rtek1000/Datalogger_2039/Hardware/readme.md

Note:
- For new projects with USB Host and certain models of STM32 it may be recommended to use an external PHY:

https://community.st.com/t5/stm32-mcu-products/is-it-possible-to-use-usb-hub-with-stm32f4-using-external-phy/m-p/569817/highlight/true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

https://community.st.com/t5/embedded-software-mcus/stm32f429-discovery-as-usb-host-problems-enumerating-low-speed/m-p/306947/highlight/true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

---------

Note:
- Editing software: KiCad E.D.A. Version: 5.1.6 [https://www.kicad.org/]

Note: Apparently there were no problems when opening the project with Kicad v6, only the first time it failed, in the following it opened the schema correctly.

Hardware Licence:
Released under CERN OHL 1.2: https://ohwr.org/cernohl
