rtek1000/Datalogger_2039/Software/README.md

Current firmware (*.hex file): [here](https://github.com/rtek1000/Datalogger_2039/tree/main/Software/Datalogger_2039%20-%20STM32/BIN/Evaluation%20version)

Current file converter: [here](https://github.com/rtek1000/Datalogger_2039/tree/main/Software/Datalogger_2039%20-%20SharpDevelop/Bin)

Notes:
- If you are using a browser on your smartphone, use the landscape screen to read more characters in the file names.
- - (These files have already been cited elsewhere, and changing the name of the folders causes corruption of the references)

- USB_HOST_HID_MSC_LCD_FLASH_RTC_ACC_TEMP3 (STM32F407VGT6 firmware):
-- Editing software: STM32CubeIDE version: 1.6.1 [https://www.st.com/en/development-tools/stm32cubeide.html]
-- Editing software: STM32CubeIDE version: 1.7.0 [https://www.st.com/en/development-tools/stm32cubeide.html]
-- Editing software: STM32CubeIDE version: 1.8.0 [https://www.st.com/en/development-tools/stm32cubeide.html]
-- Initial code development language: Brazilian Portuguese (ABNT2) [http://kbdlayout.info/KBDBR/]

- Modification:
-- 2022/02/12, LCD Backlight flashing, PWM frequency changed from ~300Hz to ~82kHz, (htim8.Init.Prescaler: from 539 to 1)

- Datalogger_2039 - STM32 - FreeRTOS - CMSIS_V1
-- Editing software: STM32CubeIDE version: 1.9.0 [https://www.st.com/en/development-tools/stm32cubeide.html]

- Datalogger_2039_File_Converter (Encoded file to decoded file):
-- From *.dat file to *.xlsx file extension
-- Editing software: B4J version: 9.30 [https://www.b4x.com/b4j.html]
-- Binary file generated by B4J (Used in the installation file: BIN folder)
-- Initial code development language: English
-- Using WPS Office to verify the exported file
-- Installation file (BIN folder) generated by Inno Setup program [https://jrsoftware.org/isinfo.php]

- Datalogger_2039_File_Converter (Encoded file to decoded file):
-- Smaller executable size, better to run on Windows XP (OffLine computer)
-- From *.dat file to *.csv file extension
-- Editing software: SharpDevelop version: 4.4.1 [https://sourceforge.net/projects/sharpdevelop/]
-- Binary file generated by SharpDevelop (Used in the installation file: BIN folder)
-- Initial code development language: English
-- Using WPS Office to verify the exported file
-- Installation file (BIN folder) generated by Inno Setup program [https://jrsoftware.org/isinfo.php]

Software License:
This library is free software; you can redistribute it and/or modify it under the terms of the GNU Lesser General Public License as published by the Free Software Foundation; either version 2.1 of the License, or (at your option) any later version.

This library is distributed in the hope that it will be useful, but WITHOUT ANY WARRANTY; without even the implied warranty of MERCHANTABILITY or FITNESS FOR A PARTICULAR PURPOSE. See the GNU Lesser General Public License for more details.

You should have received a copy of the GNU Lesser General Public License along with this library; if not, write to the Free Software Foundation, Inc., 51 Franklin St, Fifth Floor, Boston, MA 02110-1301 USA
