rtek1000/Datalogger_2039/Hardware/Hardware_2.0/Readme.md

To do:
- Check the project
- Update LCSC codes from parts list (BOM)
- Panelize the board for production (add tabs)

Note:
- The software needs to be updated to operate the battery gauge.

##### Board
- Size: 80x150mm (GERBER: 94x150mm)

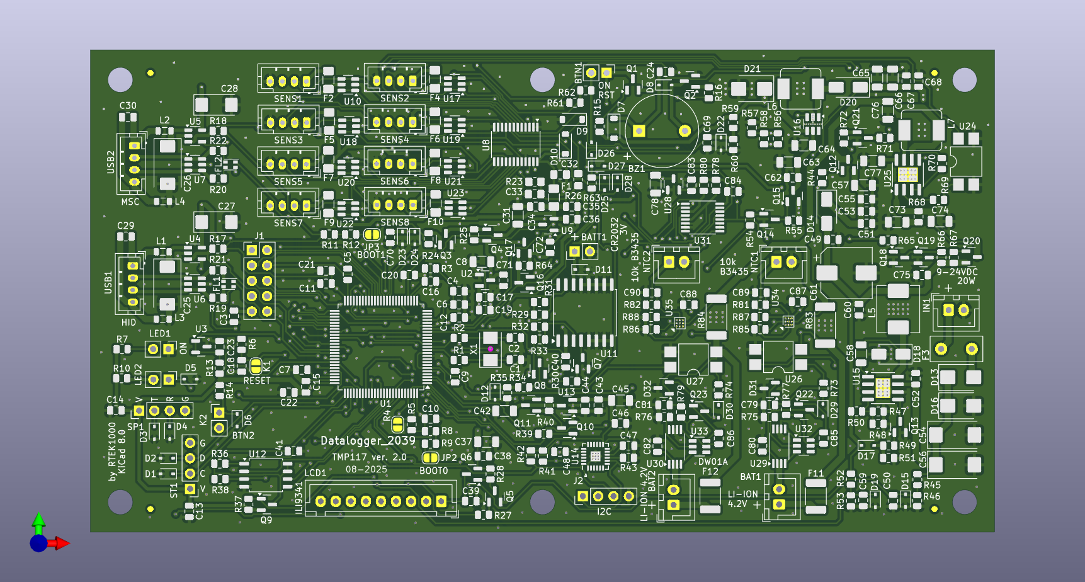
[picture p5: Hardware/Hardware_2.0/Datalogger_2039_Single_Board_T.png]


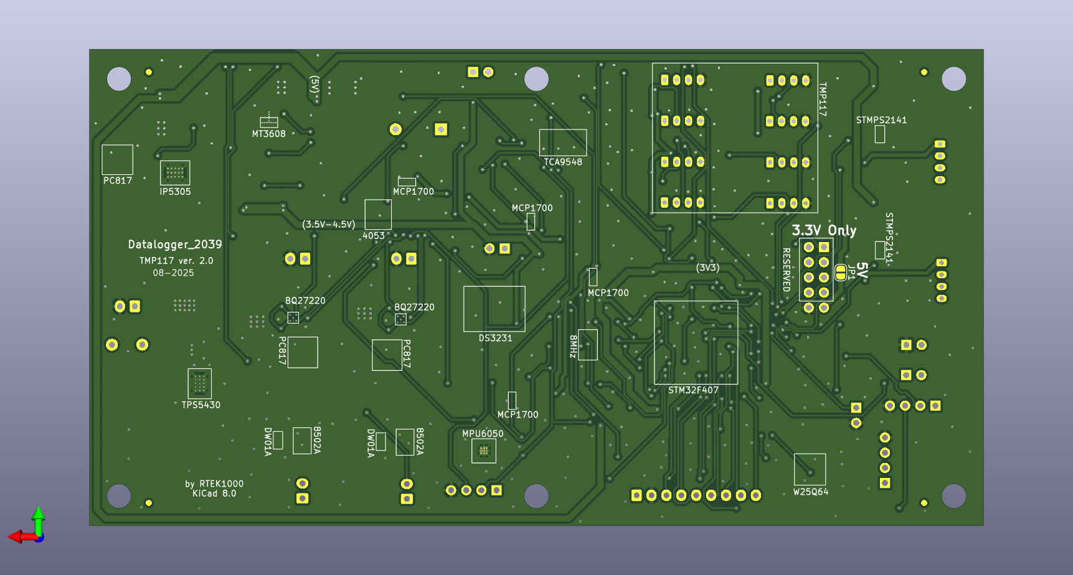
[picture p6: Hardware/Hardware_2.0/Datalogger_2039_Single_Board_B.png]


##### JLCPCB:
Notes:

- JLCPCB increased the price of the board by 9x
- - JLCPCB responded about the price being increased due to the hole size being too small

> This PCB has a minimum hole size of 0.15 mm (outer diameter 0.25/0.3 mm). High-precision PCBs with 0.15 mm (0.25/0.3 mm) vias are more difficult to manufacture. To ensure board quality, the options “4-Wire Kelvin Test” and “FR4 Tg155” are automatically applied, which led to the price increase.

- Small holes (0.15mm) have been enlarged to 0.25mm

##### Schematic
- Battery Gauge

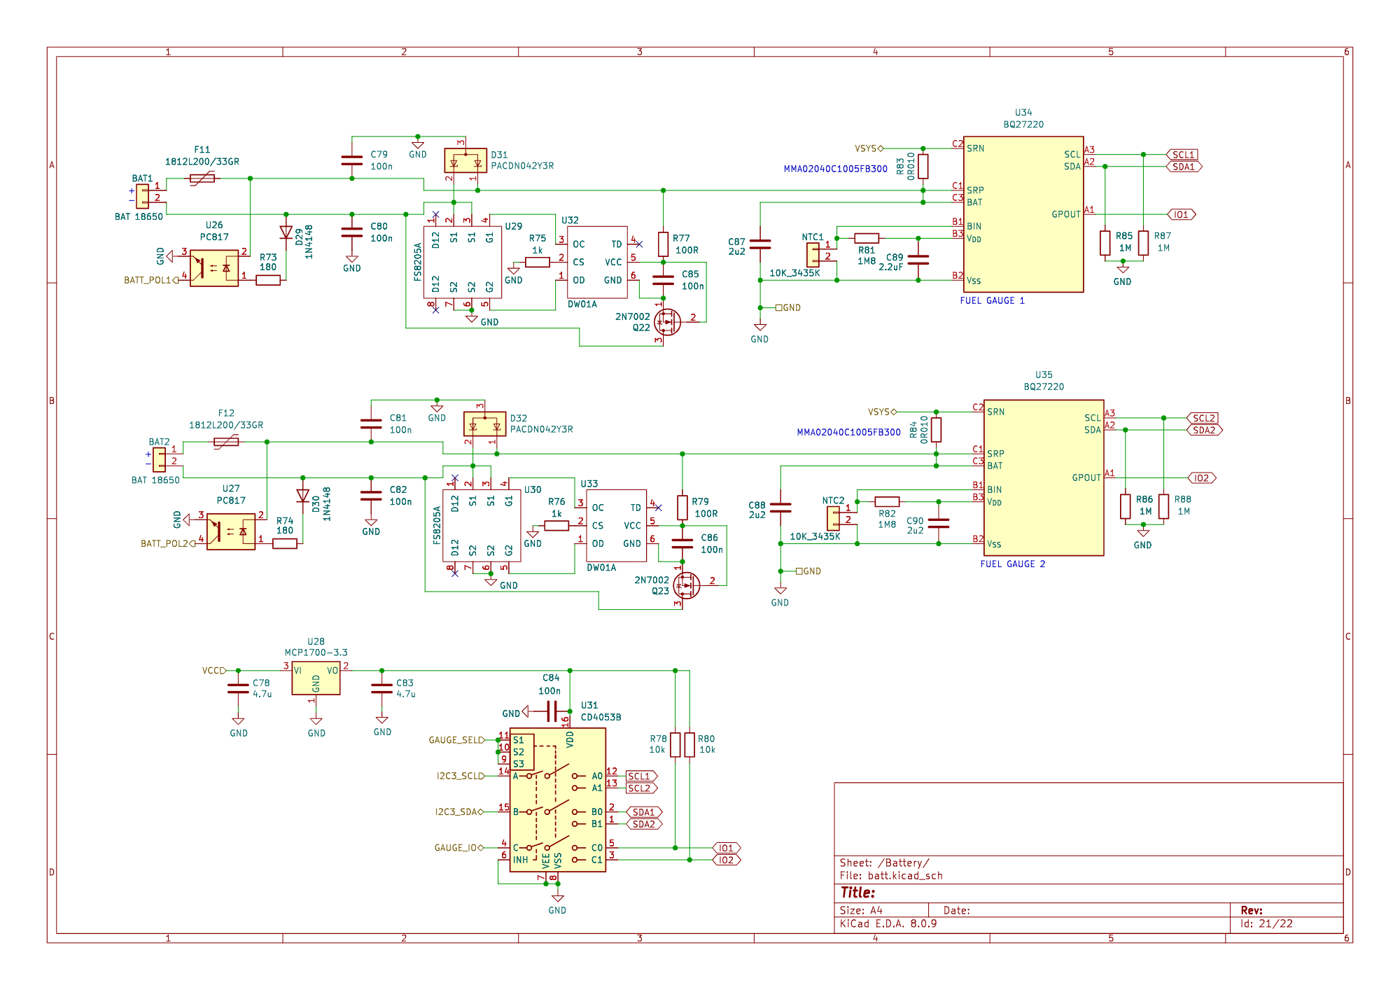
[picture p7: Hardware/Hardware_2.0/Battery_Gauge_Schematic.png]
