rtek1000/Datalogger_2039/Software/Datalogger_2039 - SharpDevelop/README.md

Current version is 0.0.7 (see [Bin](https://github.com/rtek1000/Datalogger_2039/blob/main/Software/Datalogger_2039%20-%20SharpDevelop/Bin/) folder)

If you are using a browser on your smartphone, use the landscape screen to read more characters in the file names.
- (These files have already been cited elsewhere, and changing the name of the folders causes corruption of the references)
