rtek1000/Datalogger_2039/Hardware/Datalogger2039_MCU_Pinout.xlsx

STM32F407VGT6
PA0 | ADC_VBAT | PB0 | HC595_OE (H) | PC0 | CHARGER_STATE (I, PU) | PD0 | FLASH_WP (H) | PE0 | LED2 | PH0 | OSC
PA1 | ETH_REF_CLK | PB1 | HC595_LAT | PC1 | ETH_MDC | PD1 | FLASH_PWR | PE1 | RTC_PWR | PH1 | OSC
PA2 | ETH_MDIO | PB2 | BOOT1 | PC2 |  | PD2 | UC_PWR (H) | PE2 | BUZZER
PA3 | ADC_CHARGER | PB3 | SPI1_SCK | PC3 | RTC_RESET | PD3 |  | PE3 | DC_DC_ON
PA4 | ADC_DC_DC_5V | PB4 | SPI1_MISO | PC4 | ETH_RXD0 | PD4 | LCD_PWR | PE4 | I2C3_PWR
PA5 |  | PB5 | SPI1_MOSI | PC5 | ETH_RXD1 | PD5 | LCD_RST | PE5
PA6 | ADC_VREF | PB6 | I2C1_SCL | PC6 | LCD_BACK_PWM | PD6 | LCD_DC | PE6 | ETH_PWR | (PU) | PULL-UP
PA7 | ETH_CRS_DV | PB7 | I2C1_SDA | PC7 | USB_FS_OC (I) | PD7 | LCD_CS (H) | PE7 | SENSOR_PWR | (H) | HIGH
PA8 | I2C3_SCL | PB8 | HC595_CLK | PC8 | USB_FS_PWR (H) | PD8 | USB_HS_PWR (H) | PE8 | SENSOR1 | (I) | IRQ,15,15
PA9 | USART1_TX | PB9 |  | PC9 | I2C3_SDA | PD9 | USB_HS_OC (I) | PE9 | SENSOR2 | SWD
PA10 | USART1_RX | PB10 | HC595_DAT | PC10 | SPI3_SCK | PD10 |  | PE10 | SENSOR3 | IN
PA11 | USB_FS_DM | PB11 | ETH_TX_EN | PC11 | SPI3_MISO | PD11 | BUTTON1 (I) | PE11 | SENSOR4 | ADC
PA12 | USB_FS_DP | PB12 | ETH_TXD0 | PC12 | SPI3_MOSI | PD12 | RTC_INT_STATE | PE12 | SENSOR5 | OUT
PA13 | (RST STATE) SWDIO | PB13 | ETH_TXD1 | PC13 |  | PD13 | AC_DC_STATE | PE13 | SENSOR6 | AUTO
PA14 | (RST STATE) SWCLK | PB14 | USB_HS_DM | PC14 |  | PD14 |  | PE14 | SENSOR7
PA15 | FLASH_CS (HIGH) | PB15 | USB_HS_DP | PC15 |  | PD15 | BUTTON2 | PE15 | SENSOR8
ADC |  |  |  |  | USB_OTG_FS |  |  |  |  | LCD
NVIC |  |  |  |  | MODE |  | HOST Only |  |  | 0 | VCC
ADC1/2/3 GLOB INT |  | ENABLED |  |  |  |  |  |  |  | 1 | GND
PRIORITY |  | 2 |  |  |  |  |  |  |  | 2
ADC1,2,3: PA0, PA3, PA4, PA6 |  |  |  |  | USB_OTG_HS |  |  |  |  | 3
 |  |  |  |  | MODE |  | HOST Only |  |  | 4
 |  |  |  |  | Internal FS PHY |  |  |  |  | 5
TMR7 |  |  |  |  |  |  |  |  |  | 6
MODE |  | ACTIVATED |  |  |  |  |  |  |  | 7
PARAMETER |  |  |  |  | USB_HOST |  |  |  |  | 8
PRESCALER |  | 16799 |  |  | MODE |  |  |  |  | 9
CNT PERIOD |  | 900 |  |  | CLASS FOR HS IP |  | MASS STORAGE |  |  | 10
NVIC |  |  |  |  | CLASS FOR FS IP |  | HID
TMR7 GLOB INT |  | ENABLED |  |  | (DEBUG: 3-All)
PRIORITY |  | 1 |  |  | PARAMETER |  |  |  |  | USB
 |  |  |  |  | MAX N ENDPOINT |  | 4 |  |  | 1 | VCC
 |  |  |  |  | MAX N INTERFACE |  | 4 |  |  | 2 | DM
TMR8 |  |  |  |  | MAX N CLASS |  | 2 |  |  | 3 | DP
MODE |  |  |  |  | MAX N CONFIG |  | 2 |  |  | 4 | GND
CH1 |  | PWM GEN CH1 (PC6) |  |  | MAX SIZE CONFIG |  | 512
Internal Clock |  |  |  |  | MAX DATA BUFF |  | 2048
PARAMETER |  |  |  |  |  |  |  |  |  | IWDG
PRESCALER |  | 1 |  |  | PLATFORM |  |  |  |  | ACTIVATED
CNT PERIOD |  | 1023 |  |  | DRV_VBUS_FS |  | PC8 |  |  | PRE | 64
 |  |  |  |  | DRV_VBUS_HS |  | PD8 |  |  | DN C | 4095
ETH (Disabled by software)
MODE |  | RMII |  |  | FATFS |  |  |  |  | RCC
 |  |  |  |  | MODE |  | USB Disk |  |  | HSE | CRY/CER
 |  |  |  |  | FS_READONLY |  | Read/Write (0) |  |  | IN | 8MHz
I2C1 |  |  |  |  | FS_MINIMIZE |  | basic |  |  | HCLK | 168MHz
CONFIGURATION |  |  |  |  | USE_STRFUNC |  | Enable LF-CRLF
I2C SPEED |  | FAST MODE |  |  | USE_FIND |  | Enable
 |  |  |  |  | USE_MKF |  | Enable |  |  | CRC
 |  |  |  |  | USE_FASTSEEK |  | Enable |  |  | ACTIVATED
I2C3 |  |  |  |  | USE_EXPAND |  | Enable
CONFIGURATION |  |  |  |  | USE_CHMOD |  | Enable
I2C SPEED |  | FAST MODE |  |  | USE_LABEL |  | Enable |  |  | PROJ MANAG
 |  |  |  |  | USE_FORWARD |  | Enable |  |  | HEAP | 0X4000
 |  |  |  |  | CODE_PAGE |  | U.S. (437) |  |  | STACK | 0X4000
SPI1 |  |  |  |  | USE_LFN |  | Enable HEAP
MODE |  | FULL-DUPLEX |  |  | MAX_LFN |  | 255
 |  |  |  |  | LFN_UNICODE |  | ANSI/OEM (0)
 |  |  |  |  | STRF_ENCODE |  | UTF-8 (3)
SPI3 |  |  |  |  | FS_RPATH |  | Disable (0)
MODE |  | FULL-DUPLEX |  |  | VOLUMES |  | 1
 |  |  |  |  | MULTI_PARTITION |  | Single
 |  |  |  |  | MIN_SS |  | 512
USART1 |  |  |  |  | MAX_SS |  | 512
MODE |  | ASYNC |  |  | USE_TRIM |  | Disable (0)
NVIC |  |  |  |  | FS_NOFSINFO |  | free cluster
USART1 GLOB INT |  | ENABLED
PRIORITY |  | 1
