rtek1000/Datalogger_2039/Hardware/Hardware_2.0/JLCPCB.png

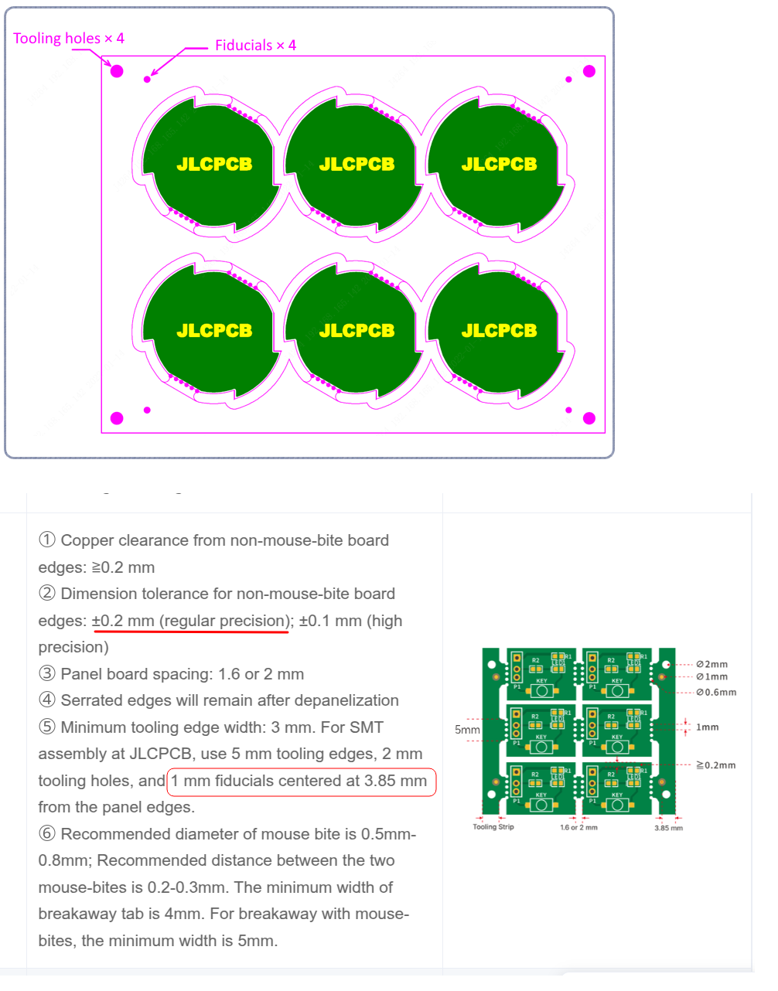
Hardware/Hardware_2.0/JLCPCB.png
