rtek1000/Datalogger_2039/Hardware/TMP117/Datalogger2039_TMP117_adapter/Datalogger2039_TMP117_adapter_2.png

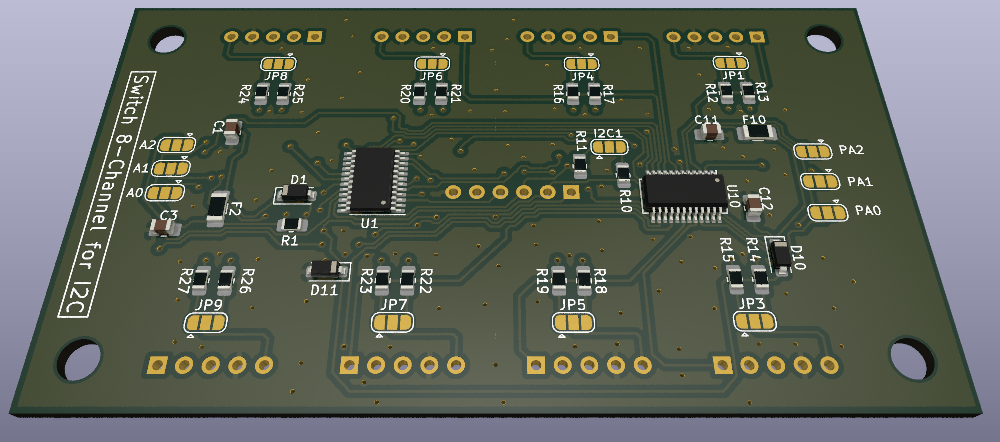
Hardware/TMP117/Datalogger2039_TMP117_adapter/Datalogger2039_TMP117_adapter_2.png
