rtek1000/Datalogger_2039/Hardware/TMP117/TMP117_Custom_Board/TMP117_custom_board/TMP117_custom_board_Bottom2.png

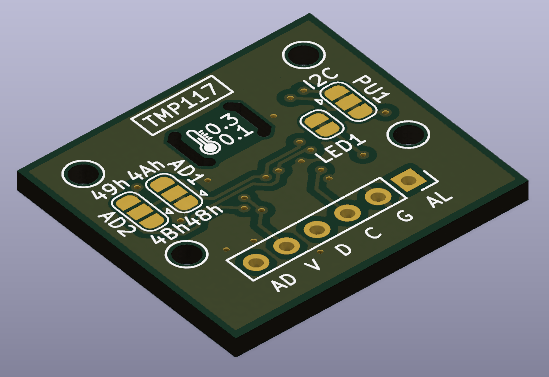
Hardware/TMP117/TMP117_Custom_Board/TMP117_custom_board/TMP117_custom_board_Bottom2.png
