rtek1000/Datalogger_2039/Hardware/TMP117/TMP117_to_USB_connector.png

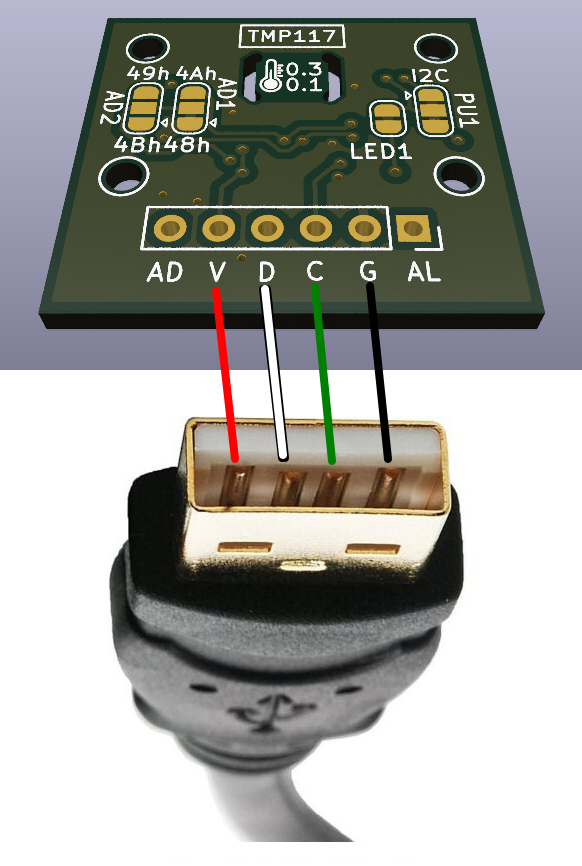
Hardware/TMP117/TMP117_to_USB_connector.png
