rtek1000/Datalogger_2039/Hardware/Wireless Mini Keyboard/Mini_Keyboard_EN-UK.jpg

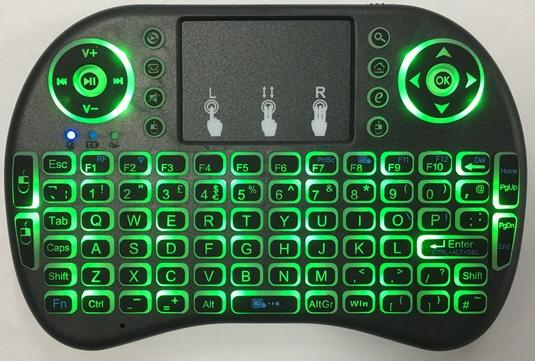
Hardware/Wireless Mini Keyboard/Mini_Keyboard_EN-UK.jpg
