rtek1000/Datalogger_2039/Hardware/Wireless Mini Keyboard/Mini_Keyboard_ES.jpg

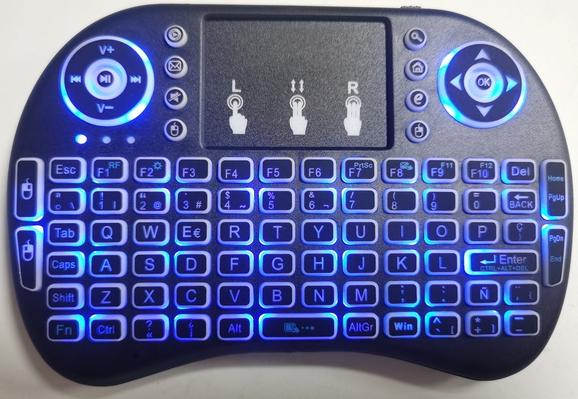
Hardware/Wireless Mini Keyboard/Mini_Keyboard_ES.jpg
