rtek1000/Datalogger_2039/Hardware/Wireless Mini Keyboard/Mini_Keyboard_HE.jpg

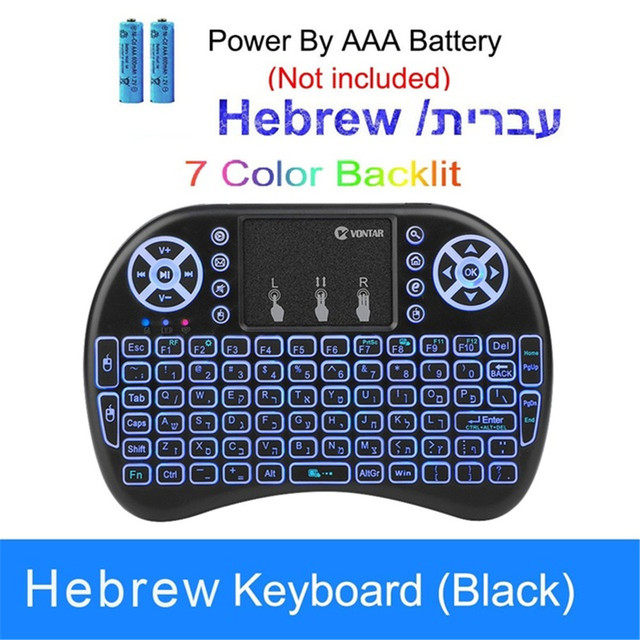
Hardware/Wireless Mini Keyboard/Mini_Keyboard_HE.jpg
