rtek1000/Datalogger_2039/Hardware/Wireless Mini Keyboard/Mini_Keyboard_RU.jpg

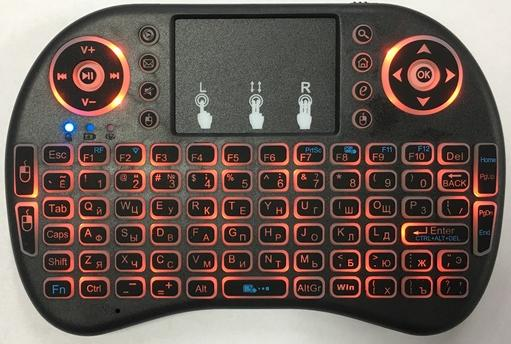
Hardware/Wireless Mini Keyboard/Mini_Keyboard_RU.jpg
