rtek1000/Datalogger_2039/Software/Datalogger_2039 - STM32/Screenshots/Chart-2022.05.07_00.52.46.png

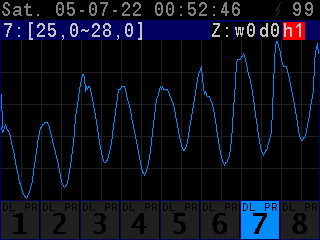
Software/Datalogger_2039 - STM32/Screenshots/Chart-2022.05.07_00.52.46.png
