rtek1000/Datalogger_2039/Software/Datalogger_2039 - STM32/Screenshots/Chart-2023.06.26_05.19.46.png

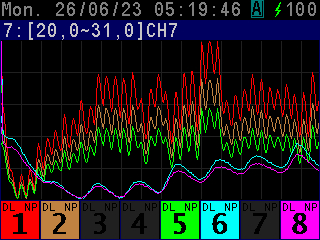
Software/Datalogger_2039 - STM32/Screenshots/Chart-2023.06.26_05.19.46.png
