rtek1000/Datalogger_2039/Software/Datalogger_2039 - STM32/Screenshots/Exp-2022.05.07_00.42.39.png

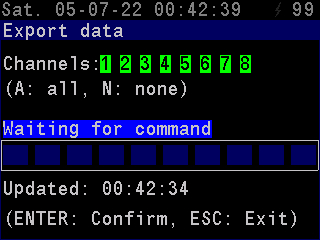
Software/Datalogger_2039 - STM32/Screenshots/Exp-2022.05.07_00.42.39.png
