rtek1000/Datalogger_2039/Software/Datalogger_2039 - STM32/Screenshots/Fmt_2023.11.11_23.01.49.png

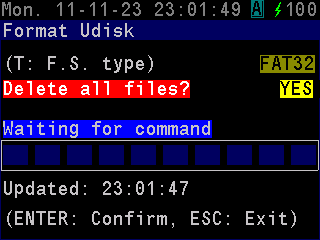
Software/Datalogger_2039 - STM32/Screenshots/Fmt_2023.11.11_23.01.49.png
