rtek1000/Datalogger_2039/Software/Datalogger_2039 - STM32/Screenshots/Lang-2022.05.07_00.45.35.png

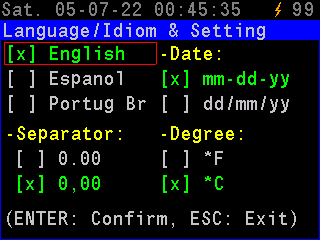
Software/Datalogger_2039 - STM32/Screenshots/Lang-2022.05.07_00.45.35.png
