rtek1000/Datalogger_2039/Software/Datalogger_2039 - STM32/Screenshots/Main_2023.11.11_23.01.04.png

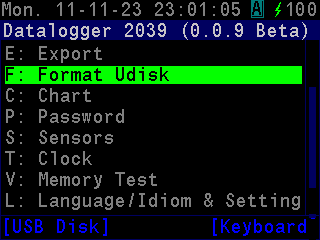
Software/Datalogger_2039 - STM32/Screenshots/Main_2023.11.11_23.01.04.png
