rtek1000/Datalogger_2039/Software/Datalogger_2039 - STM32/Screenshots/Pw-2022.05.07_00.43.16.png

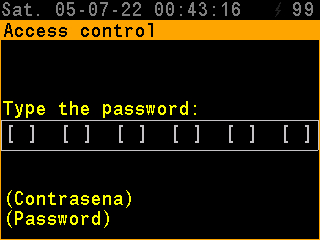
Software/Datalogger_2039 - STM32/Screenshots/Pw-2022.05.07_00.43.16.png
