rtek1000/Datalogger_2039/Software/Datalogger_2039 - STM32/Screenshots/Pw-Cfg-2022.05.07_00.46.58.png

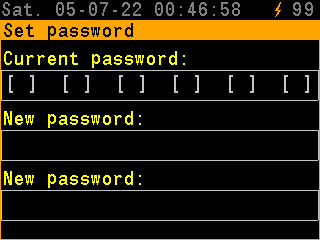
Software/Datalogger_2039 - STM32/Screenshots/Pw-Cfg-2022.05.07_00.46.58.png
