rtek1000/Datalogger_2039/Software/Datalogger_2039 - STM32/Screenshots/Sens-2022.05.07_00.46.40.png

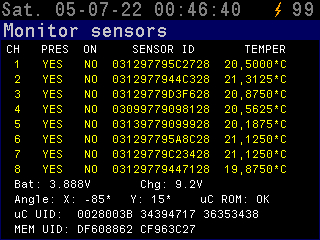
Software/Datalogger_2039 - STM32/Screenshots/Sens-2022.05.07_00.46.40.png
