rtek1000/Datalogger_2039/Software/Firmware update/(EN) Android firmware burn.png

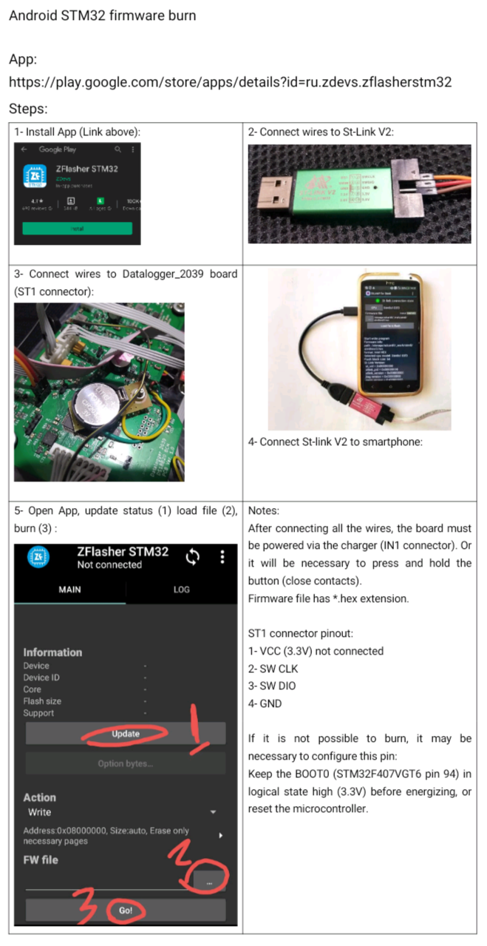
Software/Firmware update/(EN) Android firmware burn.png
