rtek1000/Datalogger_2039/Software/Firmware update/(ES) Programación de STM32 a través de Android.png

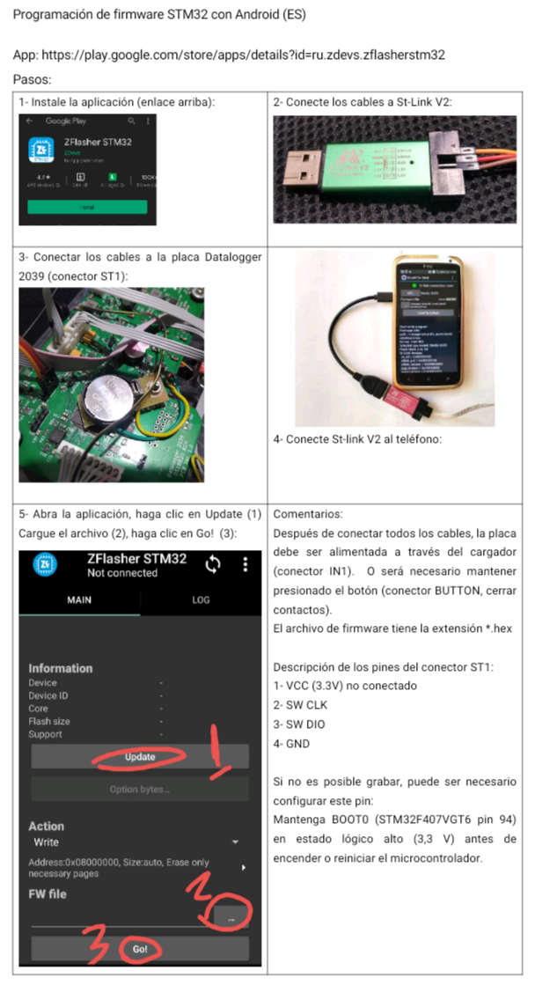
Software/Firmware update/(ES) Programación de STM32 a través de Android.png
