rtek1000/Datalogger_2039/(threads)

Thread 1 (2023-03-27):

Num Lock Caps Lock Scroll lock status

arslan437, 2023-03-27:
Regarding this thread

https://community.st.com/s/question/0D53W00000FNNDF/usb-host-keyboard-output-report-how-to-control-the-3-leds-numlock-caps-lock-and-scroll-lock-status

Here my is the situation,
- Stm32 is connected to computer with Keyboard HID code done in cube IDE
- Another Actual keyboard is connected to same computer

Is it possible to check with stm32 if someone has pressed any of the num lock, scroll lock, or caps lock keys on the actual key.

Thanks for your help in advance.

rtek1000, 2023-03-27:
Hello,

I believe this is done by the Operating System.

I already connected two physical keyboards to the STM32F407 using each USB port as a HOST and for the keyboards to have this synchronization, the STM32 had to manage the keyboard state.

So try connecting two physical keyboards to your computer to test, if they don't sync, try another operating system or another keyboard.

If the physical keyboards work correctly then it will be necessary to implement all equivalent support for handling the LEDs. Note that the LEDs are indicative states. Only the FN keys can have some internal keyboard function, the rest are sent to the HOST and then it manages CAPS LOCK, SHIFT, CONTROL, ALT etc.

arslan437, 2023-03-27:
I have connected two keysboards. And they in perfect sync. When I click one capslock on one keyboard it do turn on the lights on both the key board.

Not sure sure how can I get the stauts on the stm32. Is there any resources from where I can get the information.

rtek1000, 2023-06-03:
Hi, as it has been a while since there have been more interactions, I will leave this issue closed, if necessary you can open an issue again, thank you.

rtek1000, 2023-06-05:
Very good! Thanks for the feedback!

It would be interesting to share a didactic example, if you can.

(I share what I can to maybe help the community make progress on other unrealized issues and maybe help prevent these MCUs from ending)

rtek1000, 2023-06-06:
Thanks for your return,

Surely someone will appreciate your effort!

Closed 2023-06-03.
