rtek1000/Datalogger_2039/Hardware/Datalogger_2039.pdf

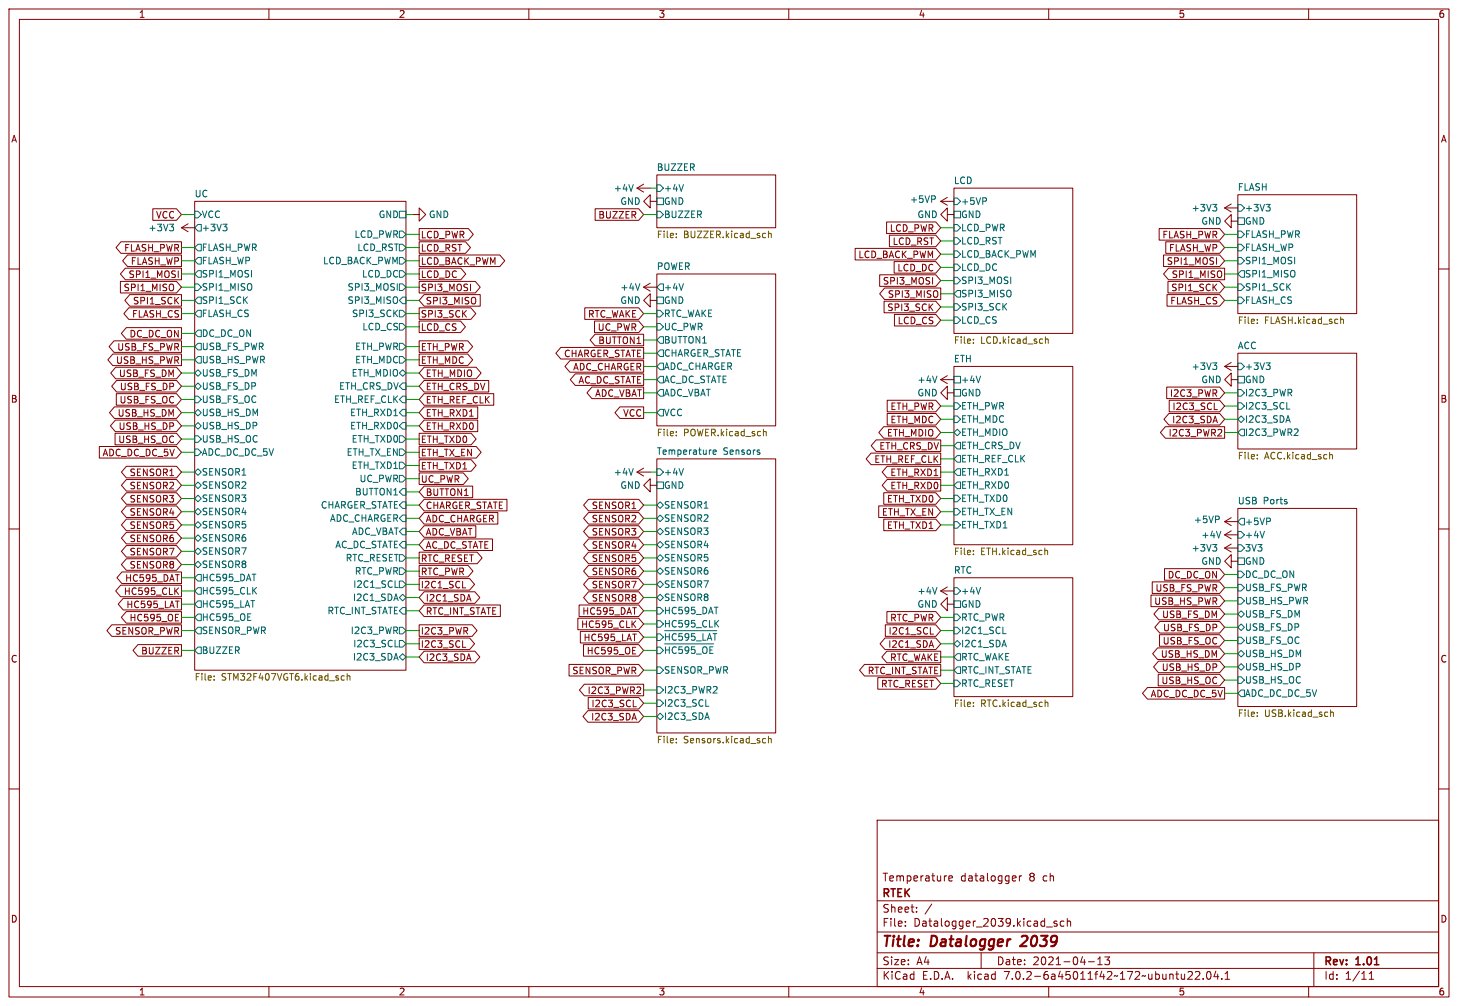
[picture p57: page 1]

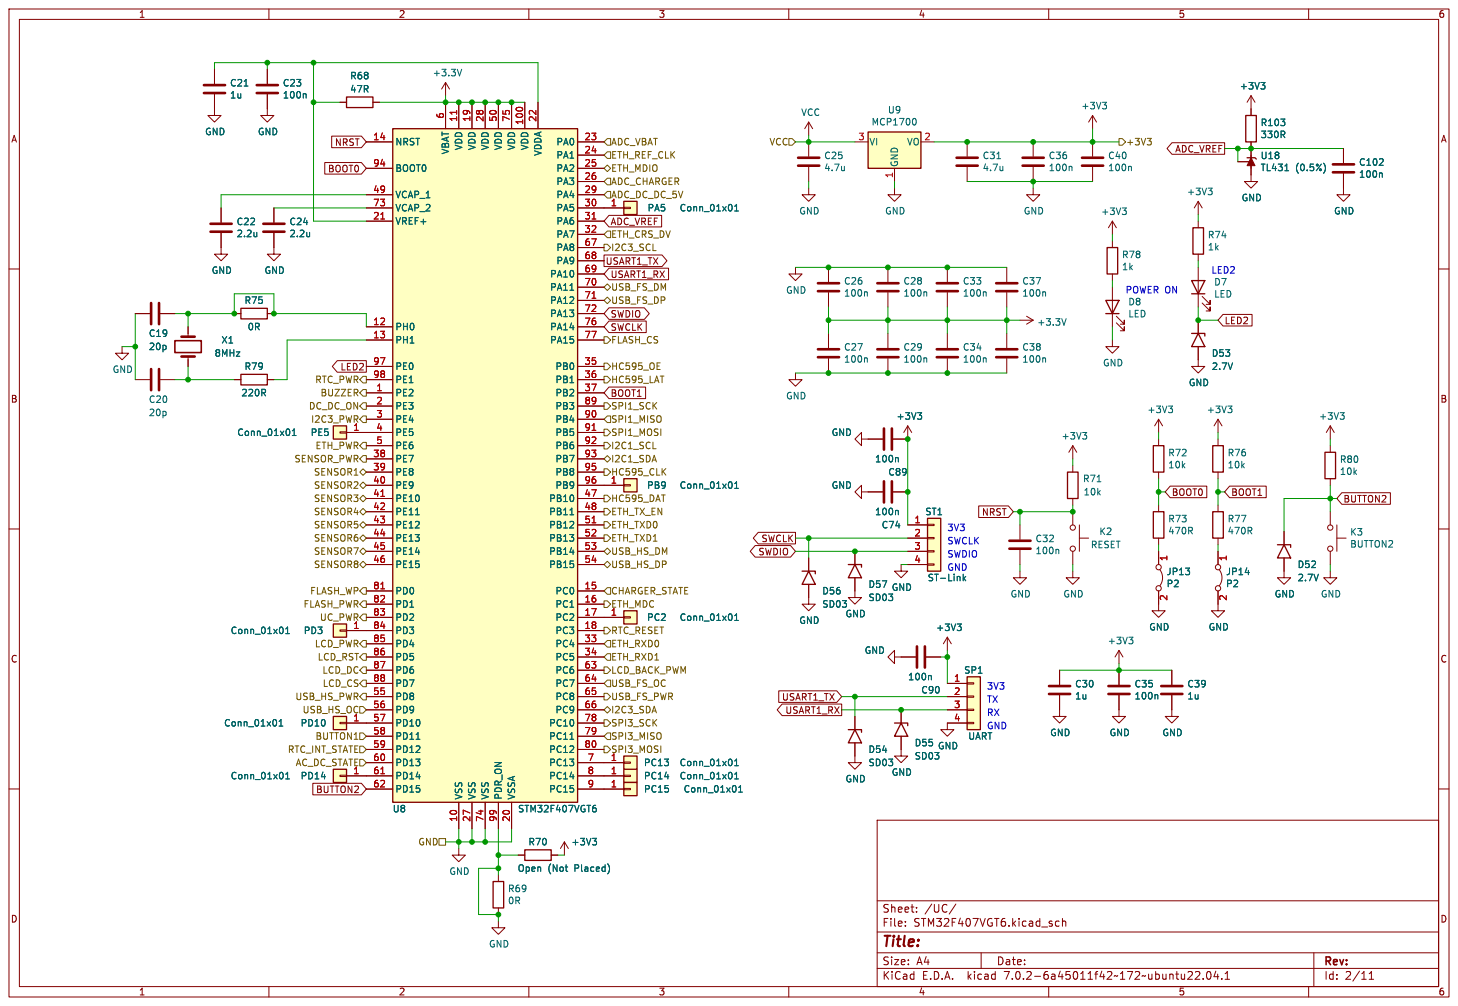
[picture p58: page 2]

Id: 2/11 Title: File: STM32F407VGT6.kicad_sch Sheet: /UC/

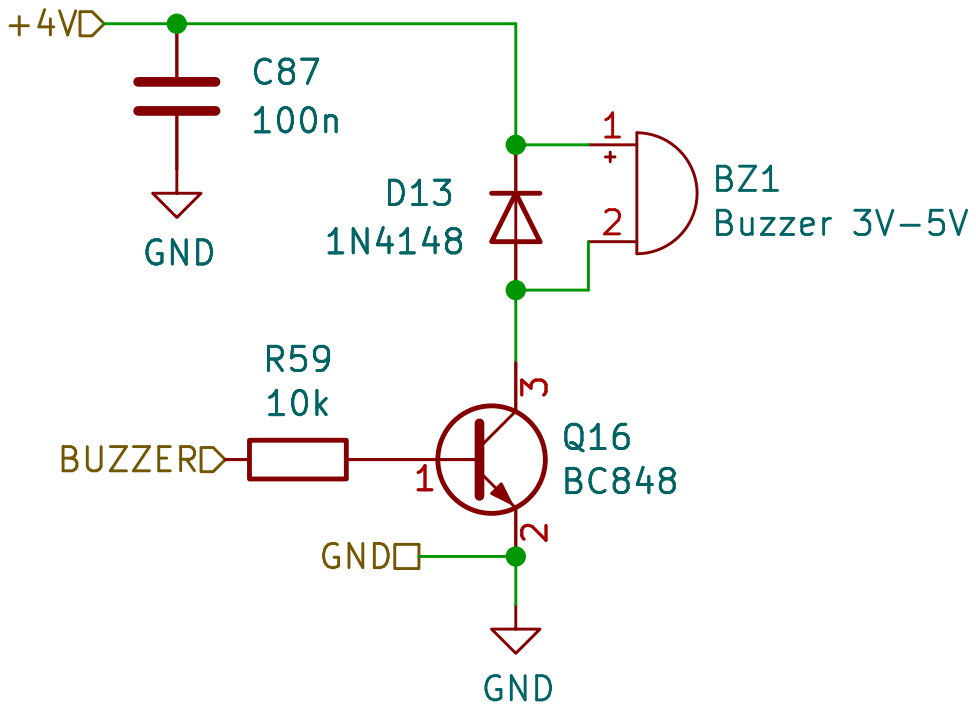
[picture p59: page 3]

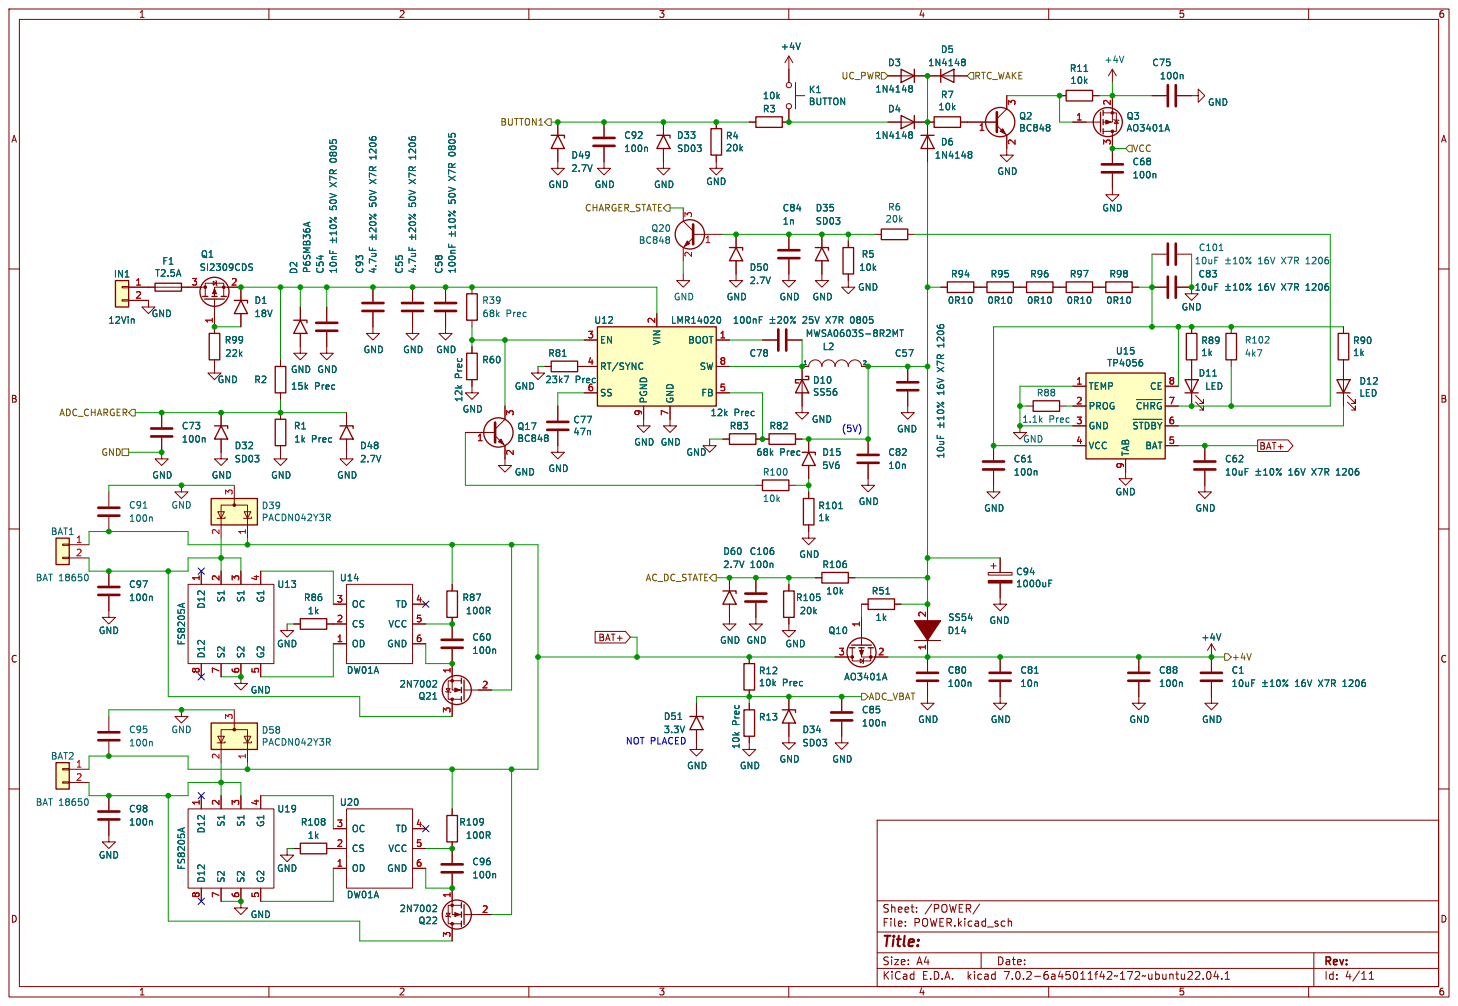
[picture p60: page 4]

2 3 Q2 BC848 GND OD 1 CS 2 OC 3 TD 4 VCC 5 GND 6 U14DW01A

2 EN 3 RT/SYNC 4 FB 5 SS 6 GND

BAT+ BAT+ NOT PLACED

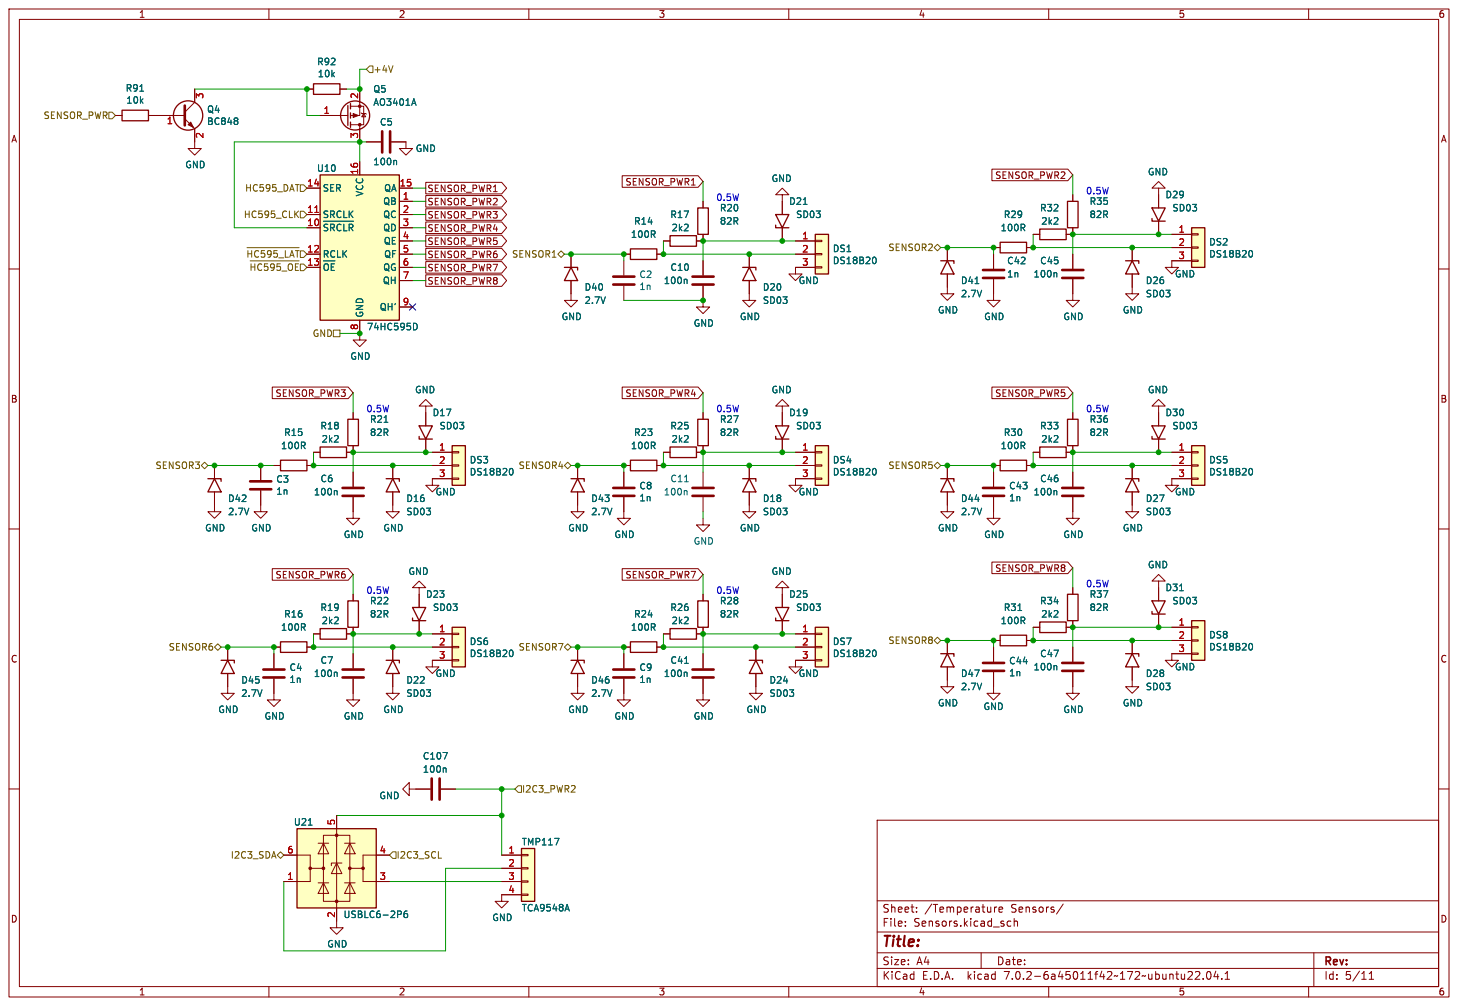
[picture p61: page 5]

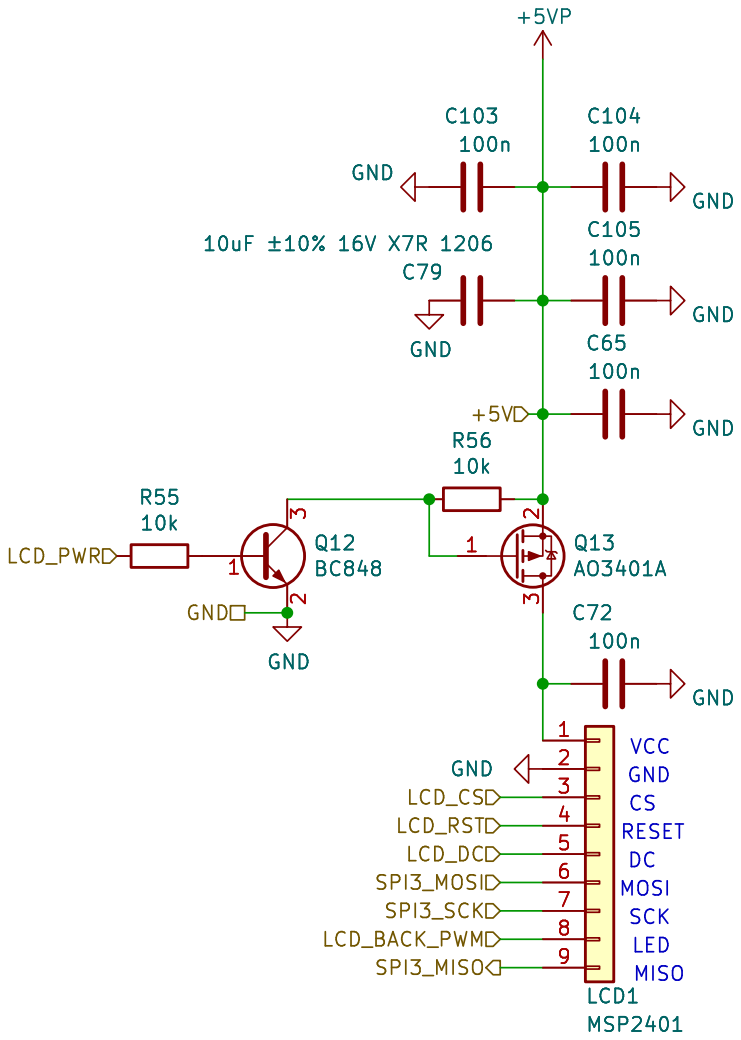
[picture p62: page 6]

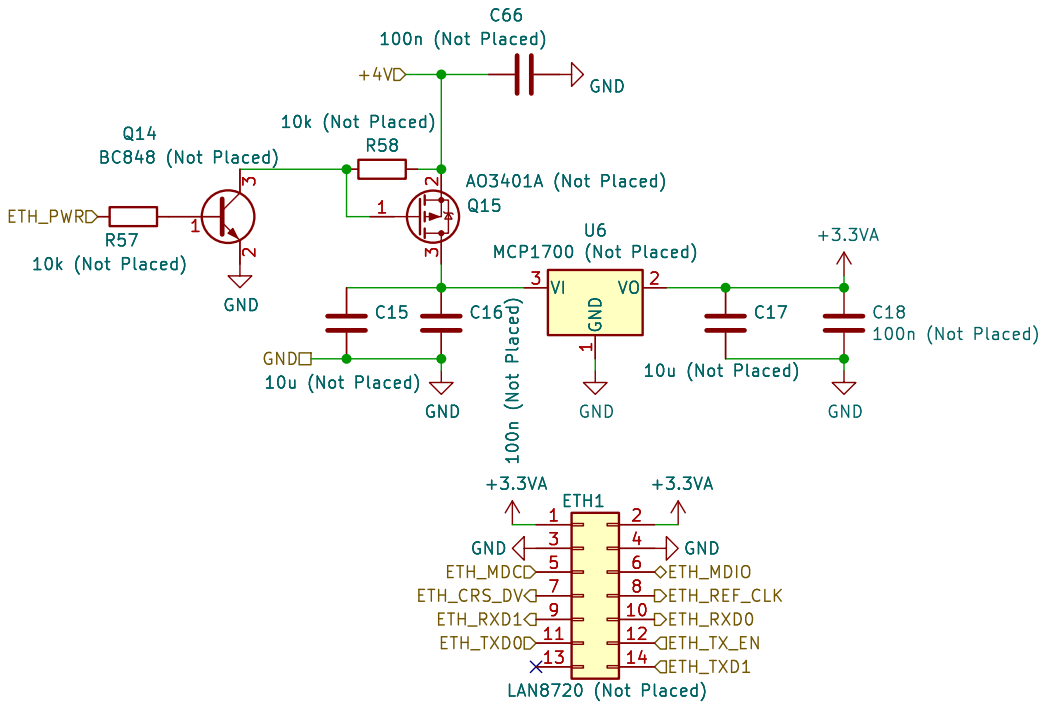
[picture p63: page 7]

100n (Not Placed) Q15 AO3401A (Not Placed) 1

10k (Not Placed) Q14 BC848 (Not Placed) 1

1 VO 2 VI 3 U6 MCP1700 (Not Placed) +3.3VA
+3.3VA GND GND

1 VO 2 VI 3 C16 100n (Not Placed) C17

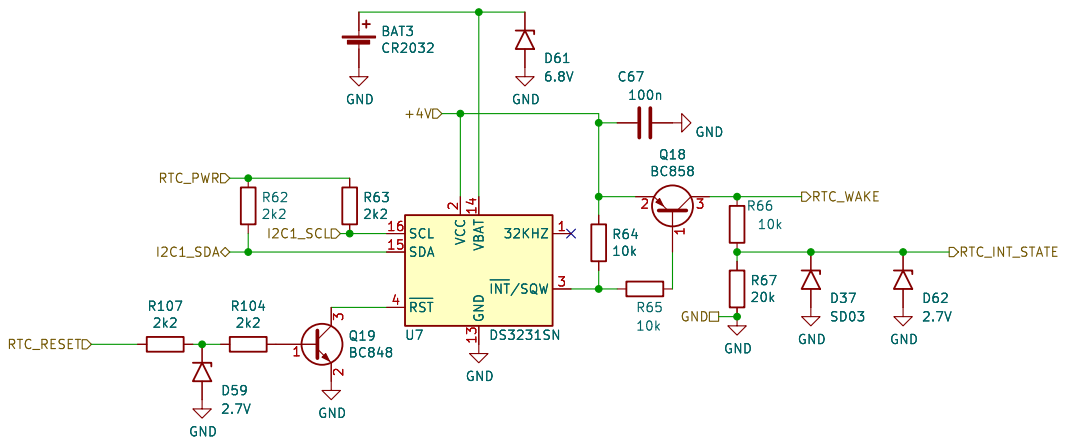
[picture p64: page 8]

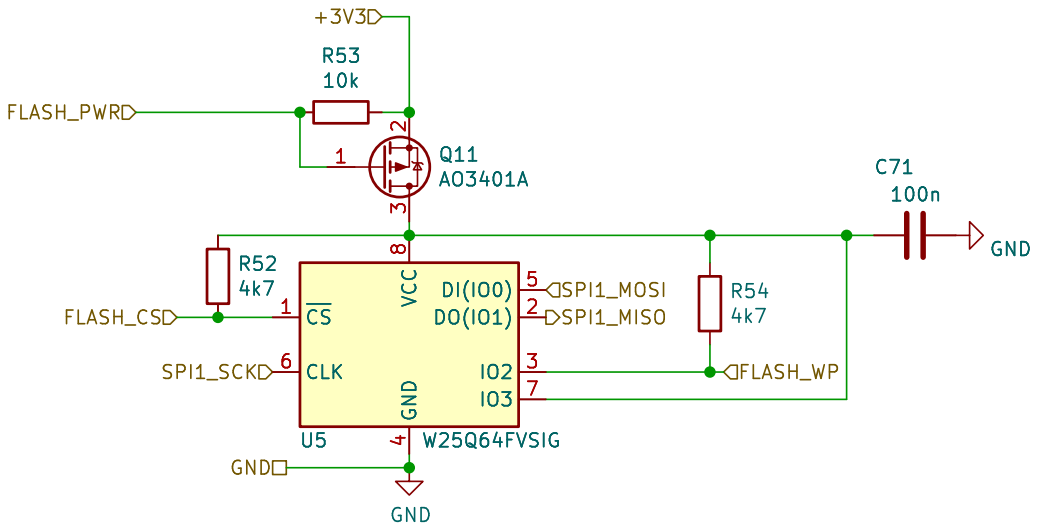
[picture p65: page 9]

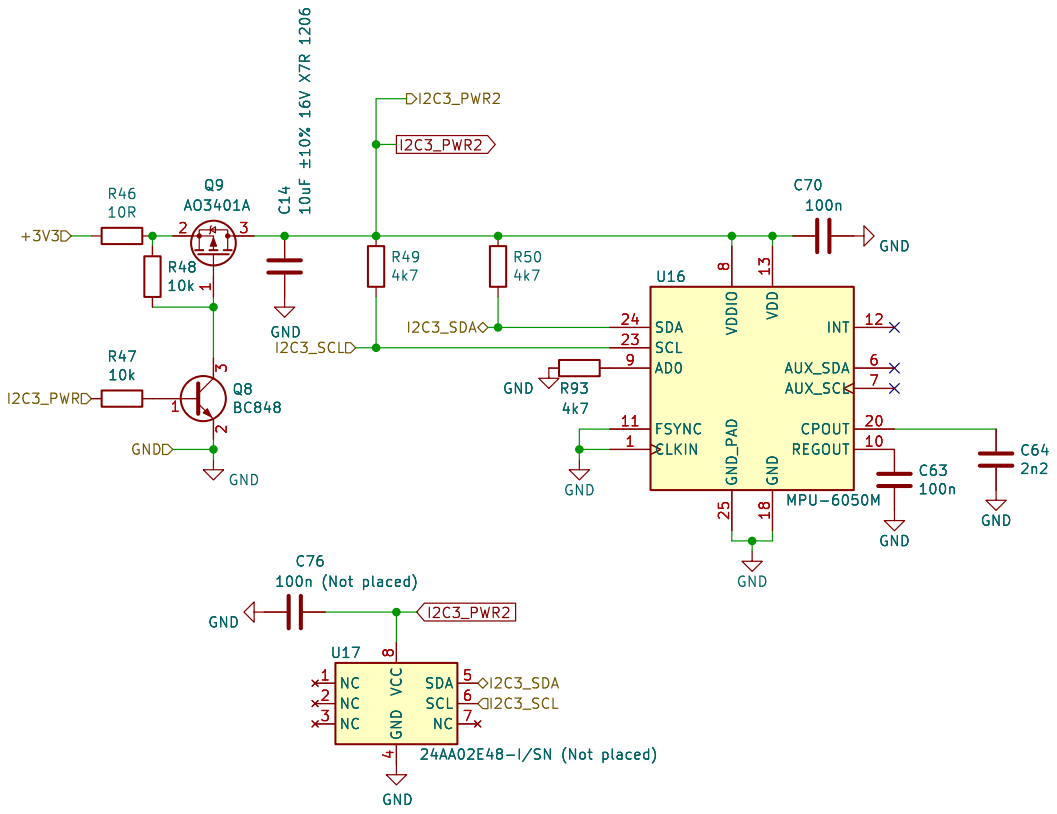
[picture p66: page 10]

4 SDA 5 SCL 6 NC 7 VCC

Id: 10/11 Title: File: ACC.kicad_sch Sheet: /ACC/

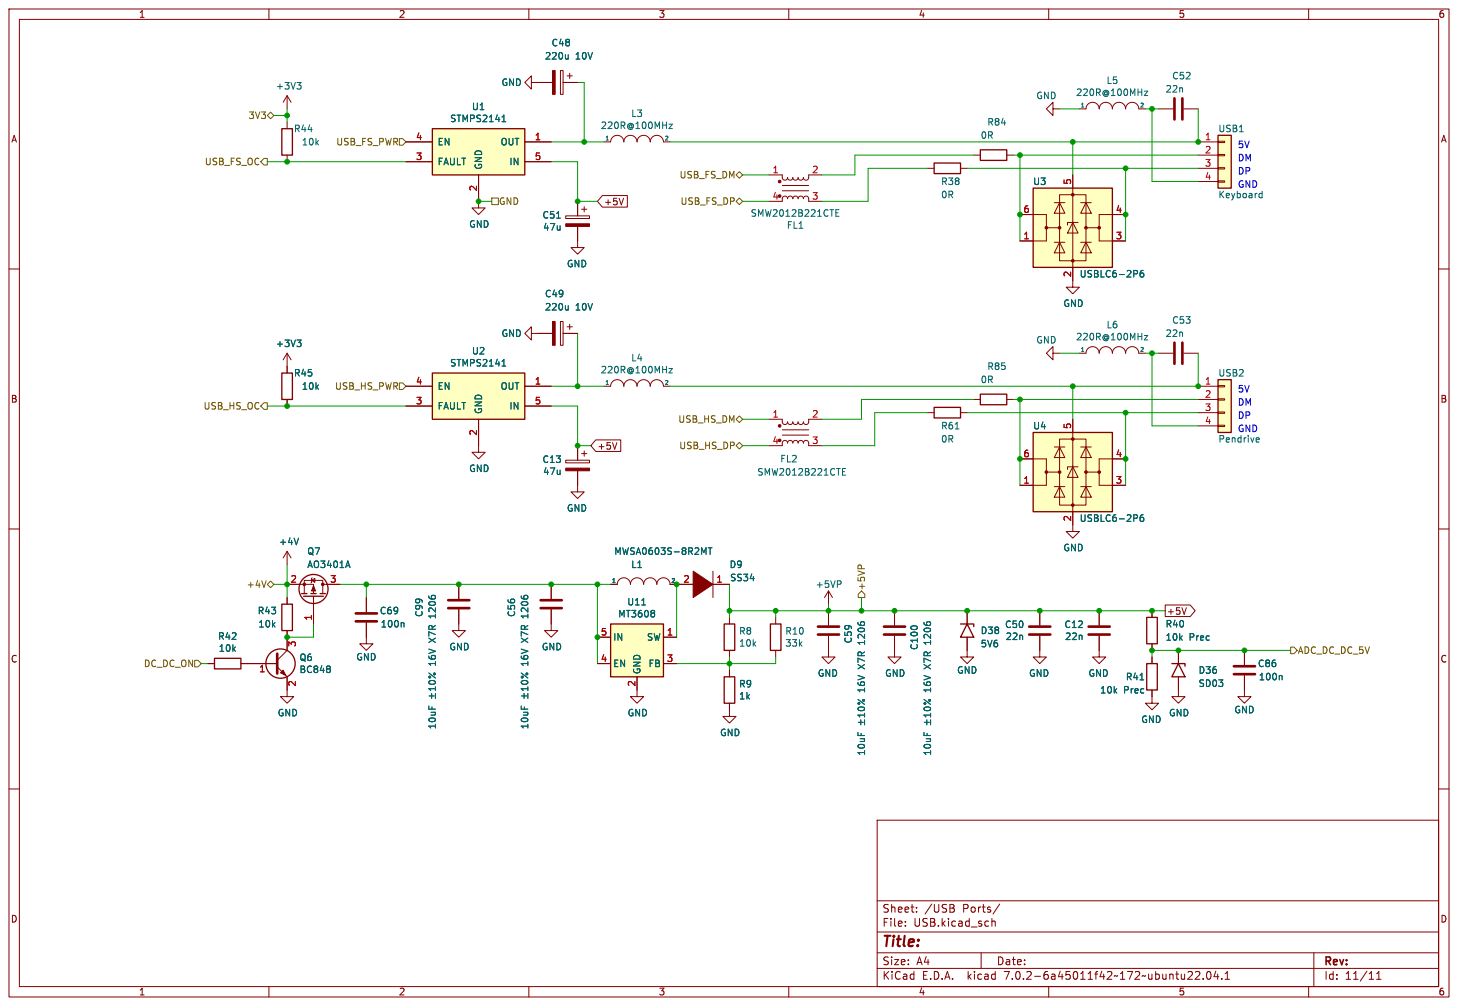
[picture p67: page 11]
