rtek1000/Datalogger_2039/Hardware/Hardware_2.0/Datalogger_2039_Single_Board.pdf

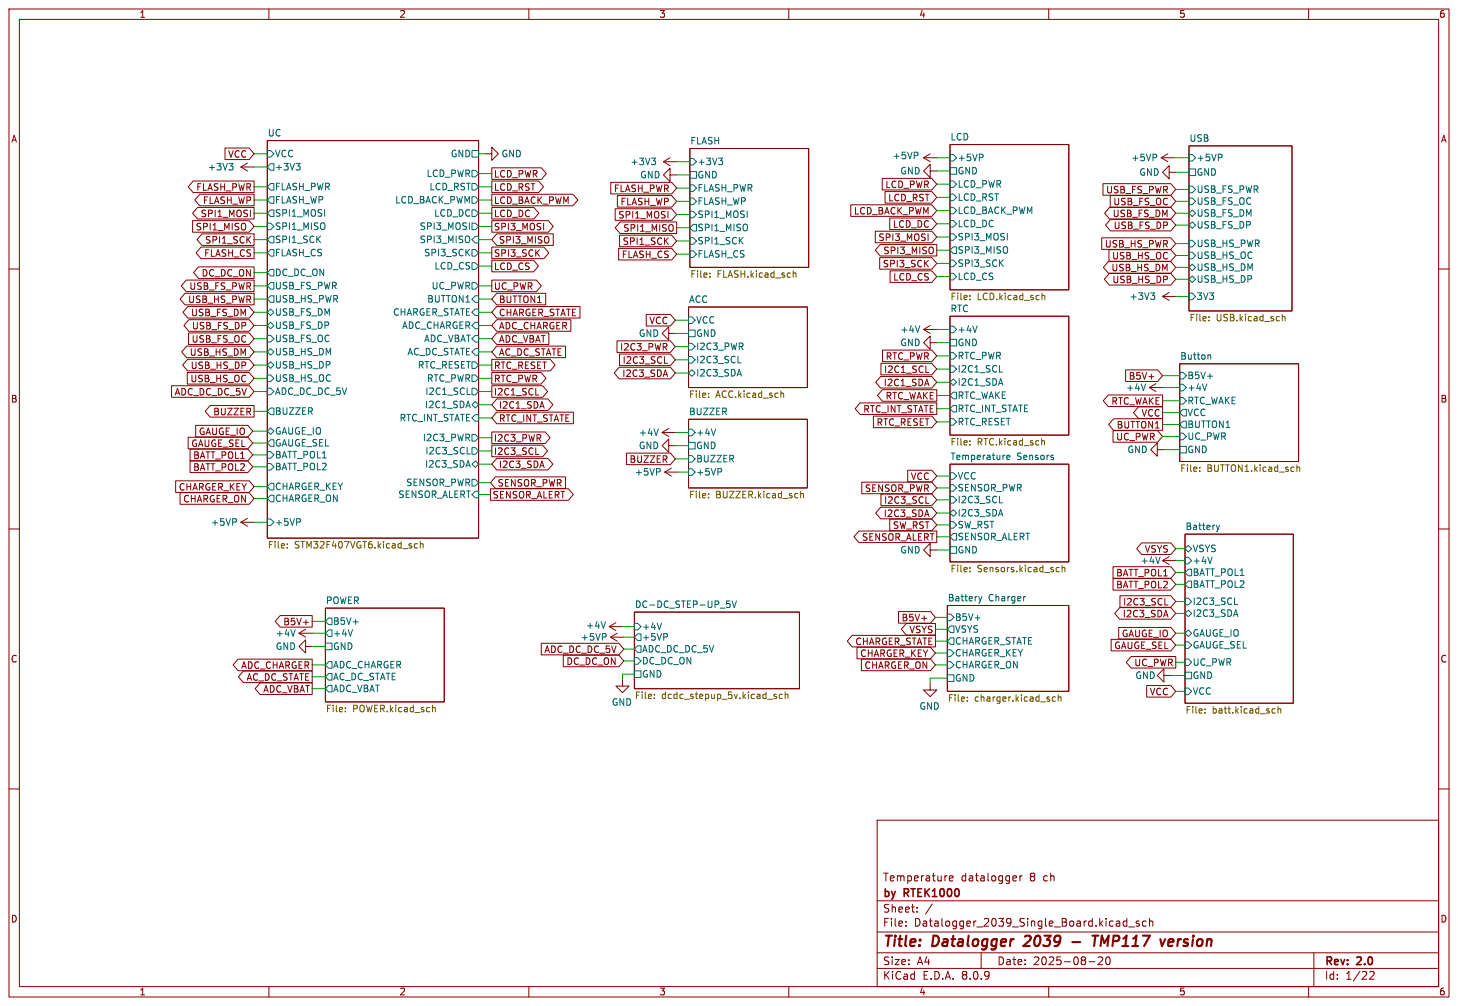
[picture p68: page 1]

Battery Charger File: charger.kicad_sch GND

Id: 1/22 Title: Datalogger 2039 - TMP117 version

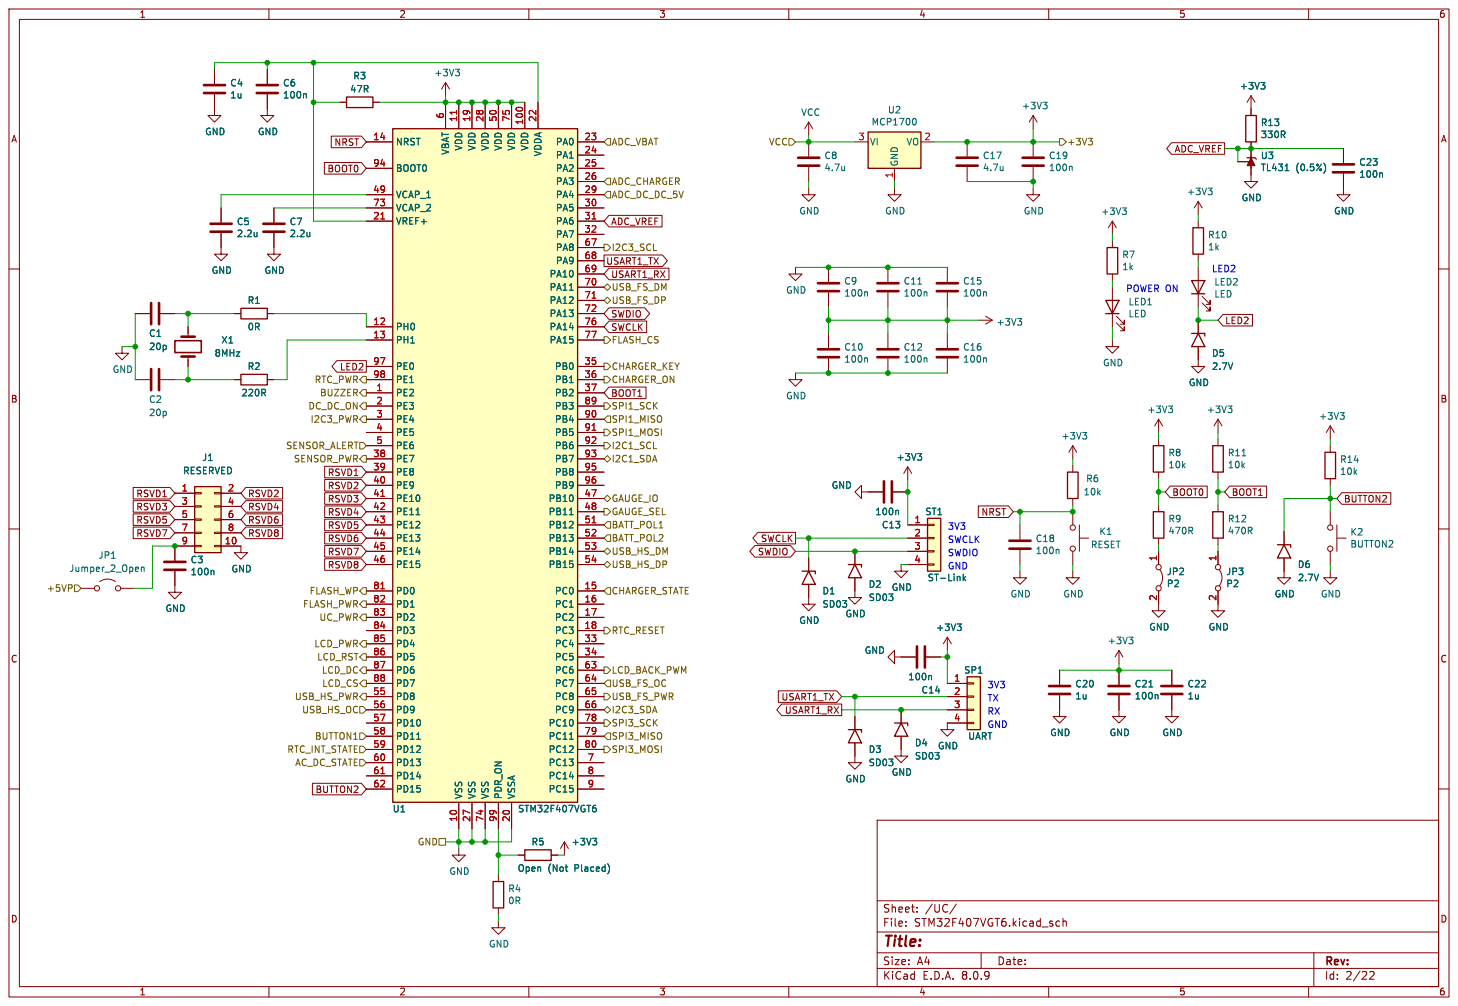
[picture p69: page 2]

Id: 2/22 Title: File: STM32F407VGT6.kicad_sch Sheet: /UC/

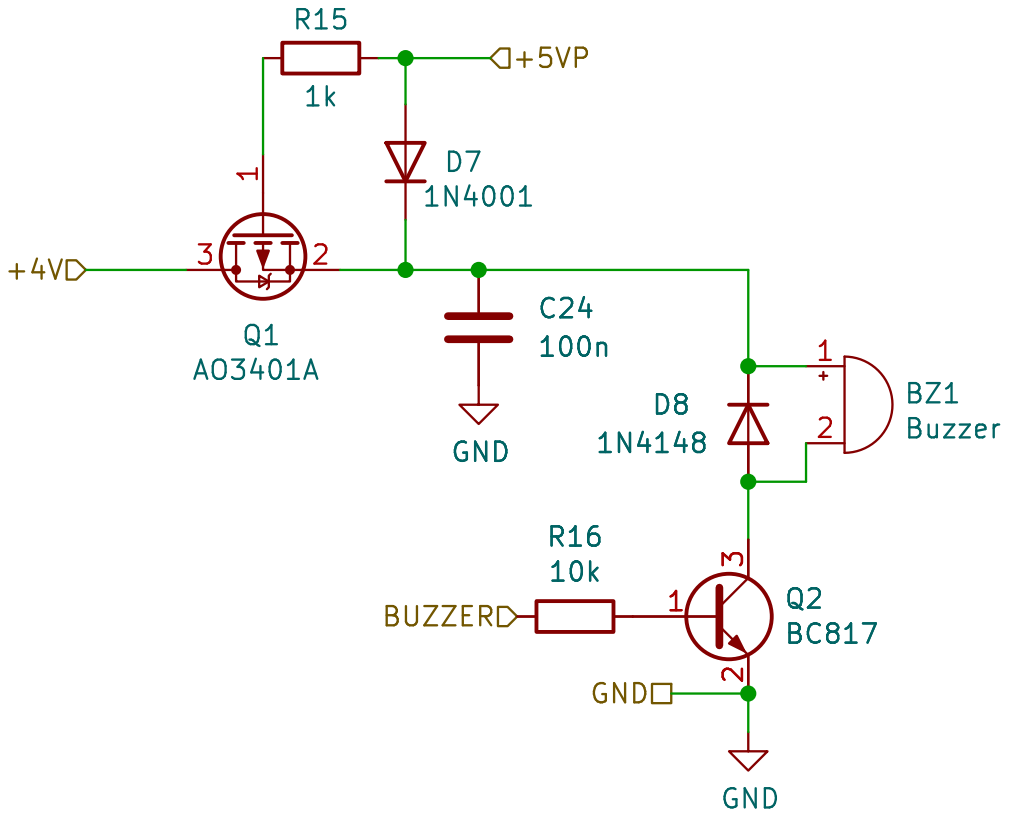
[picture p70: page 3]

Id: 3/22 Title: File: BUZZER.kicad_sch Sheet: /BUZZER/

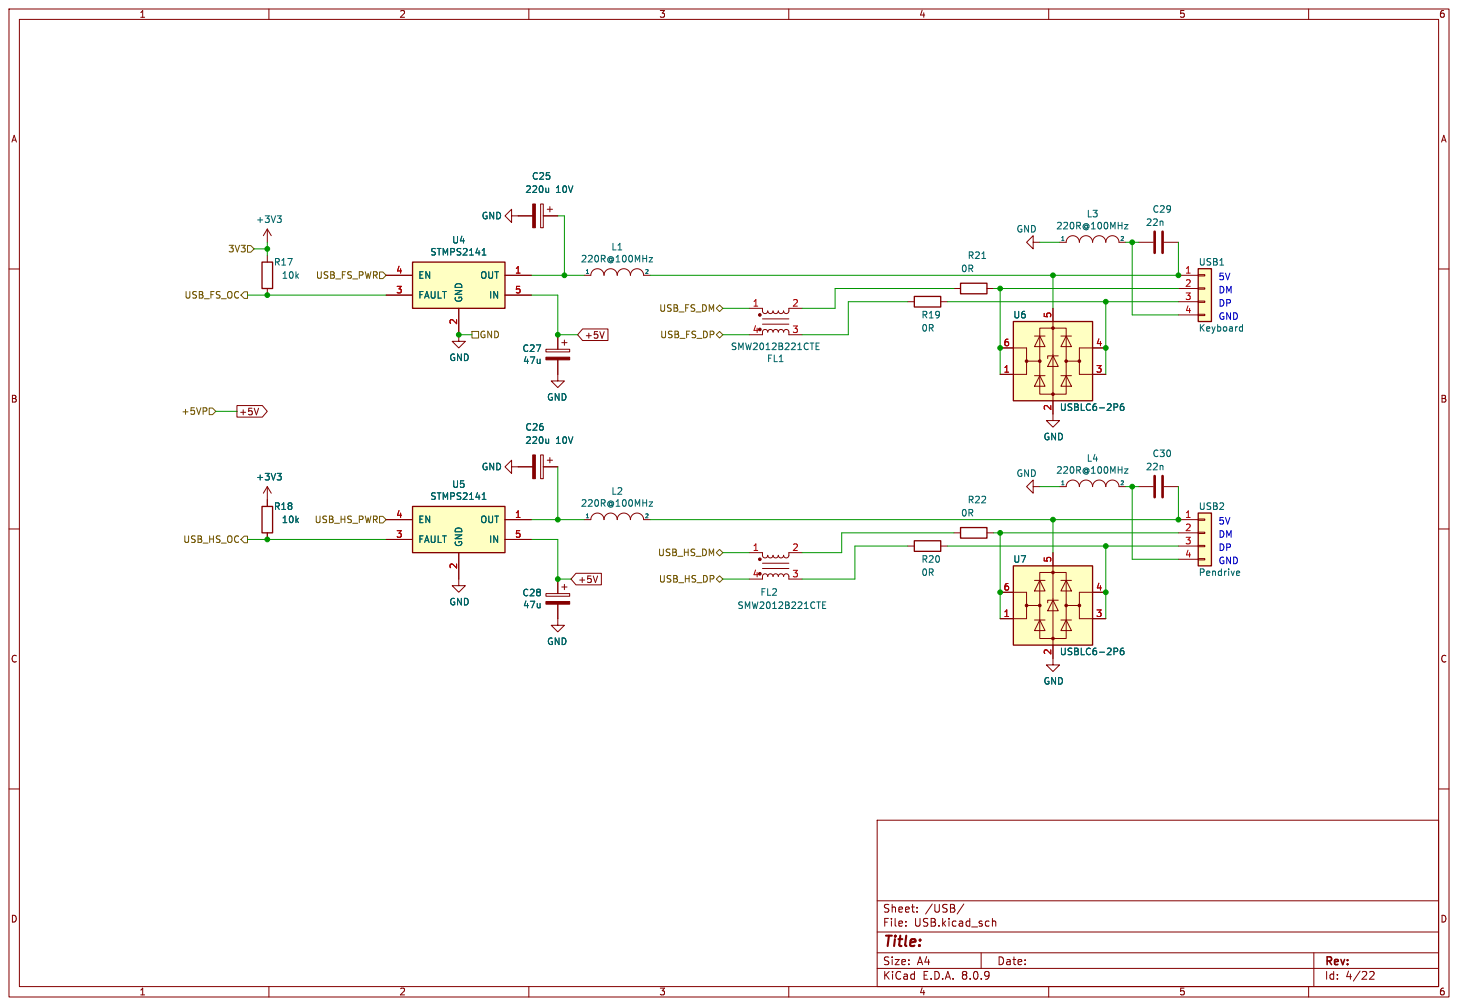
[picture p71: page 4]

Id: 4/22 Title: File: USB.kicad_sch Sheet: /USB/ GND

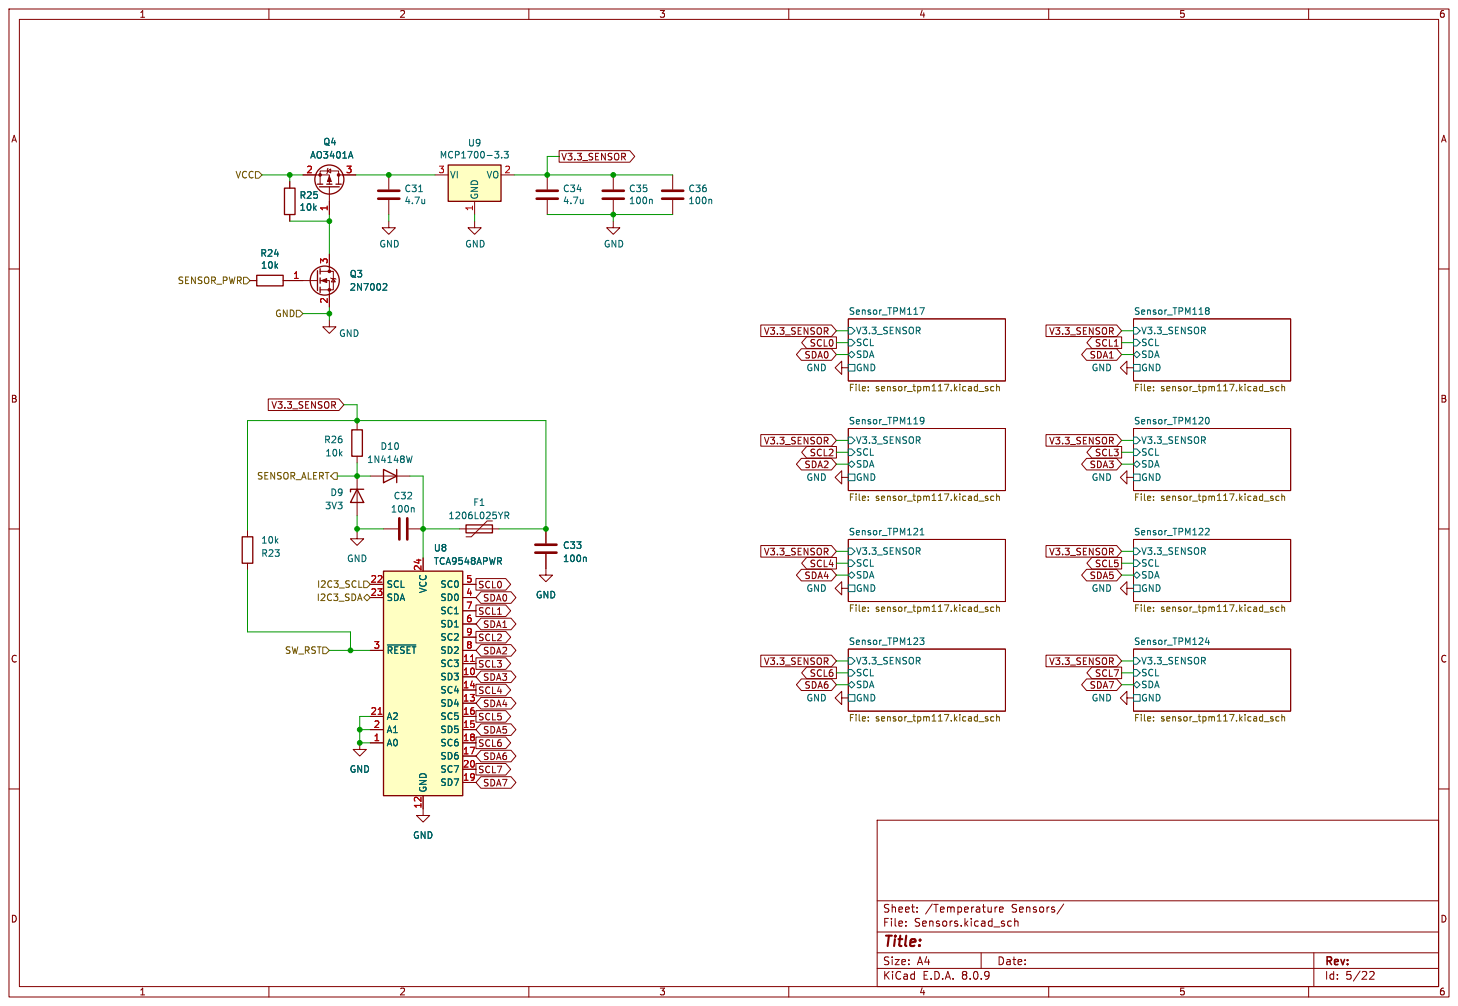
[picture p72: page 5]

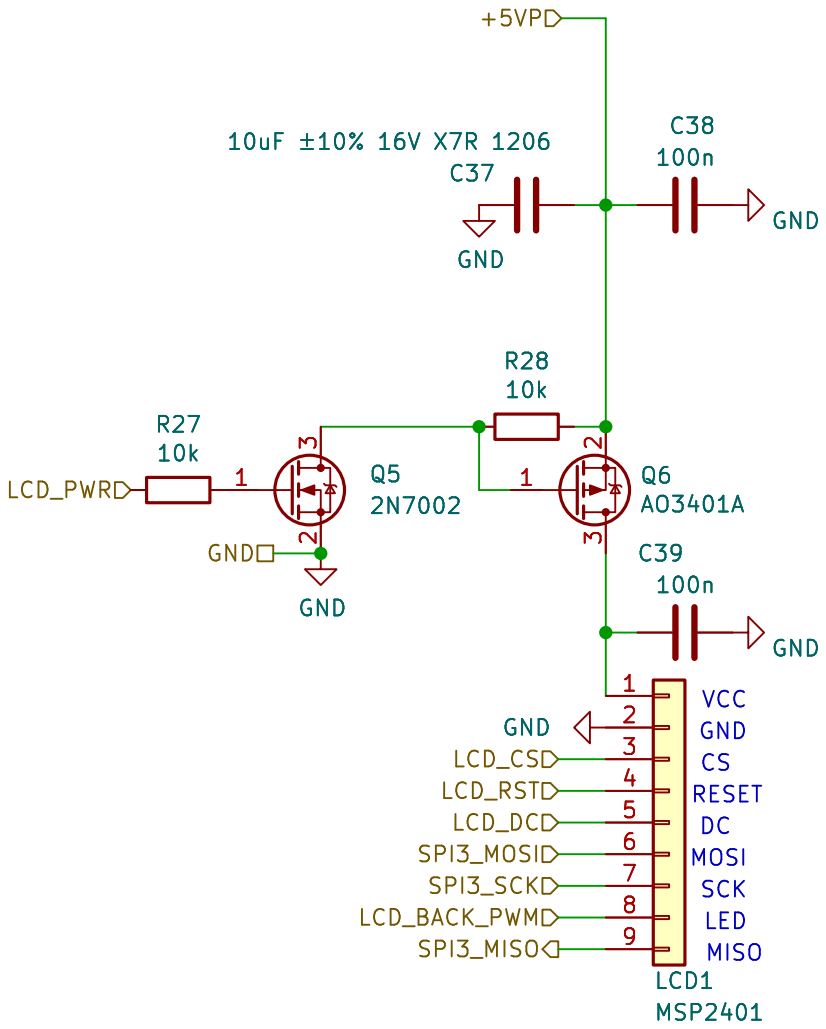
[picture p73: page 6]

Id: 6/22 Title: File: LCD.kicad_sch Sheet: /LCD/

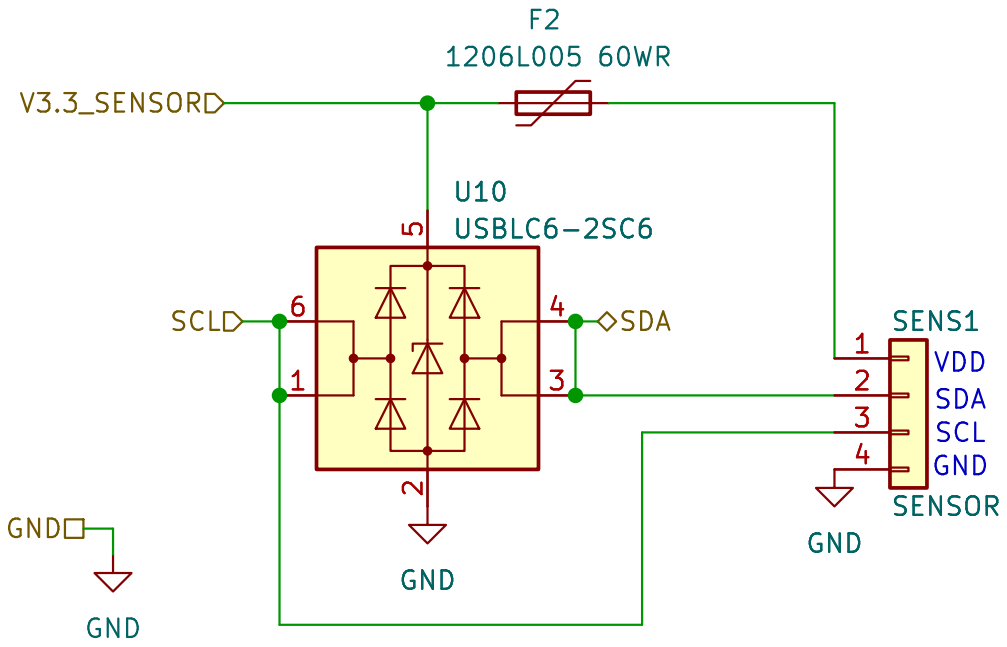
[picture p74: page 7]

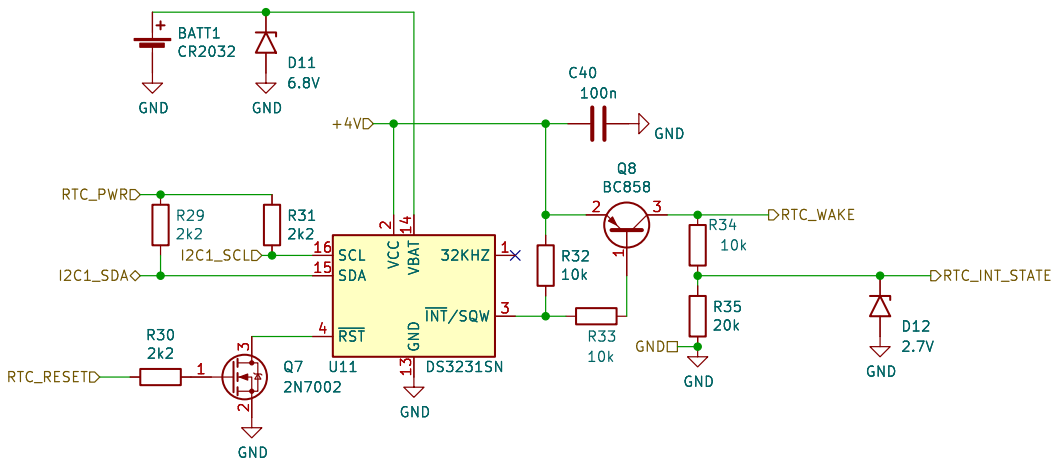
[picture p75: page 8]

2 ~{INT}/SQW3 ~{RST} 4 U11 DS3231SN GND GND

2 ~{INT}/SQW3 ~{RST} 4 GND GND

Id: 8/22 Title: File: RTC.kicad_sch Sheet: /RTC/

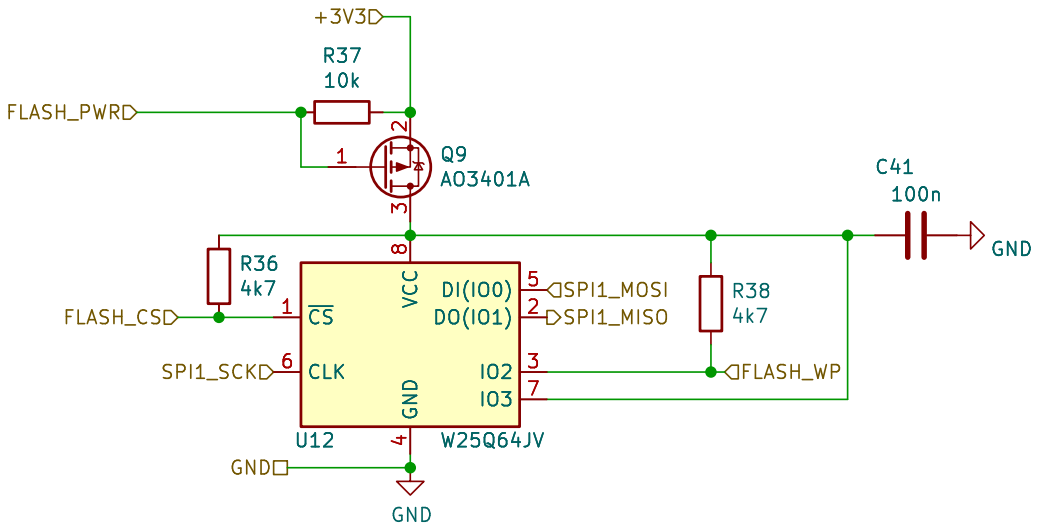
[picture p76: page 9]

Id: 9/22 Title: File: FLASH.kicad_sch Sheet: /FLASH/ R38

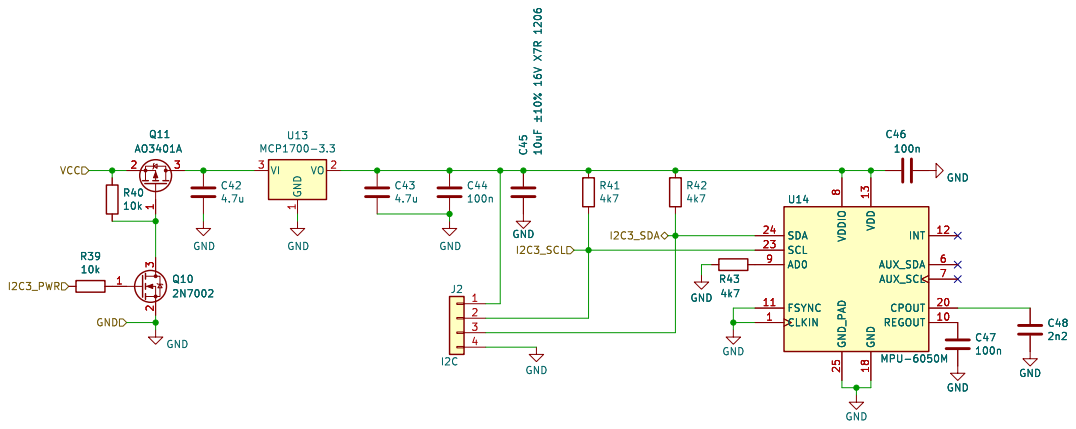
[picture p77: page 10]

Id: 10/22 Title: File: ACC.kicad_sch Sheet: /ACC/

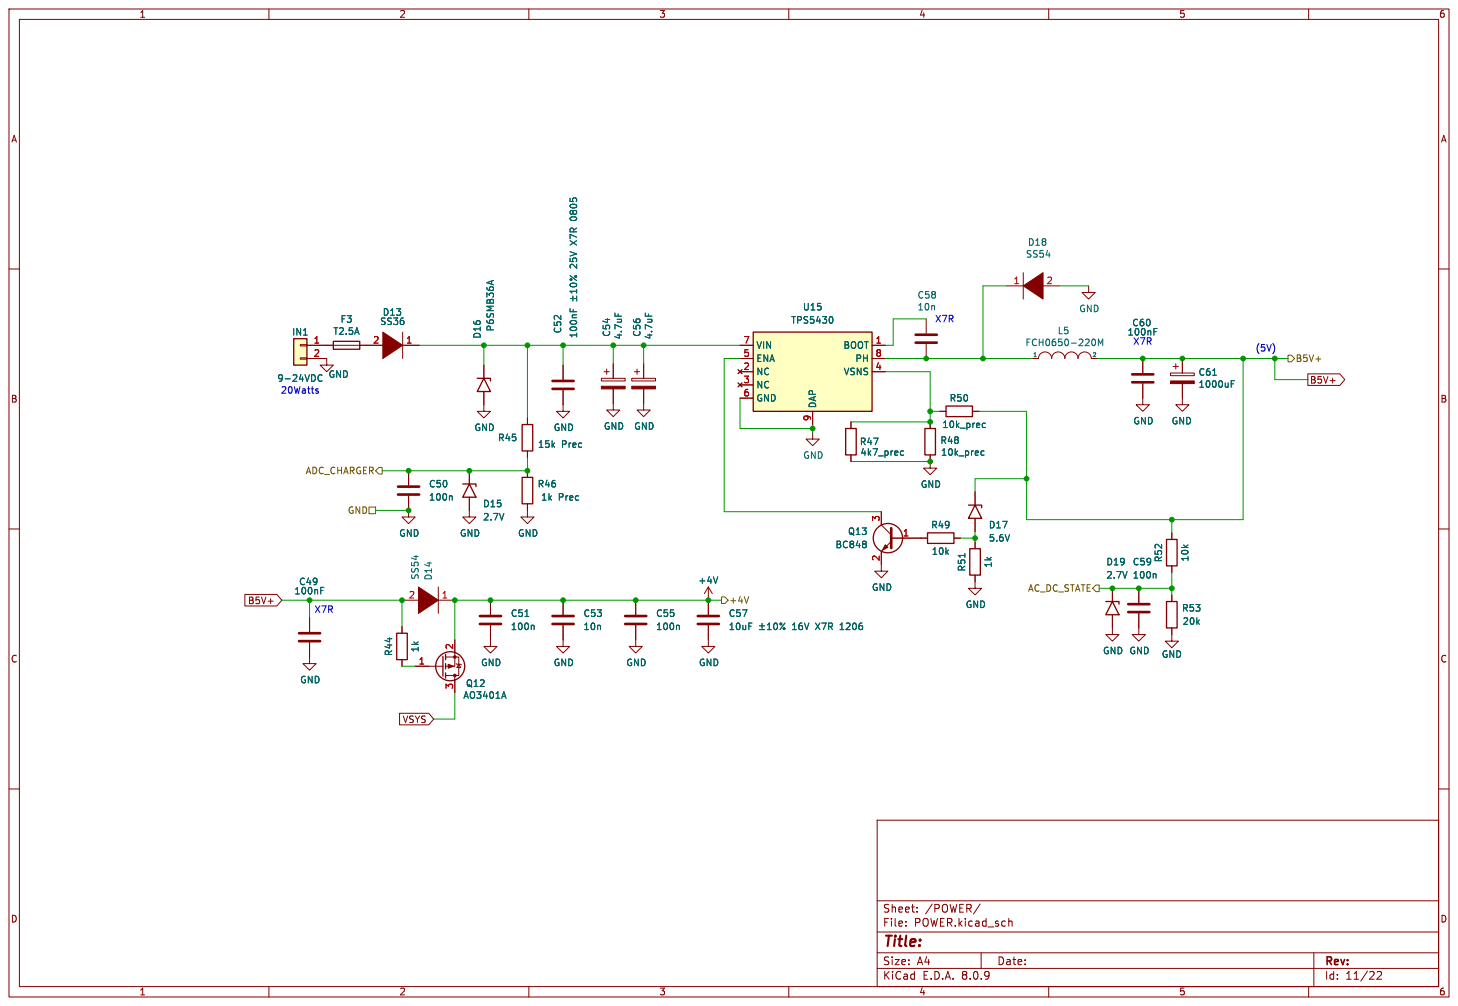
[picture p78: page 11]

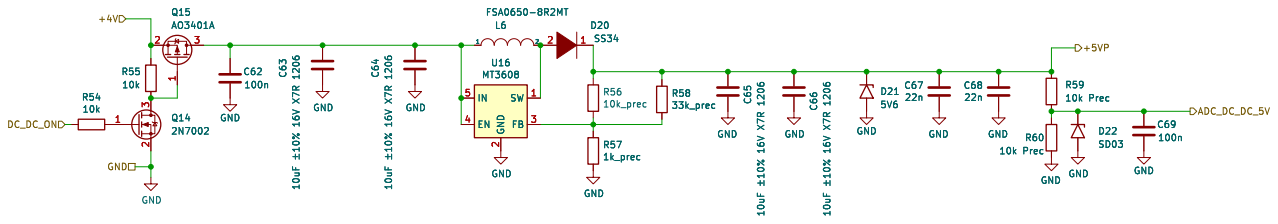
[picture p79: page 12]

Id: 12/22 Title: File: dcdc_stepup_5v.kicad_sch Sheet: /DC-DC_STEP-UP_5V/

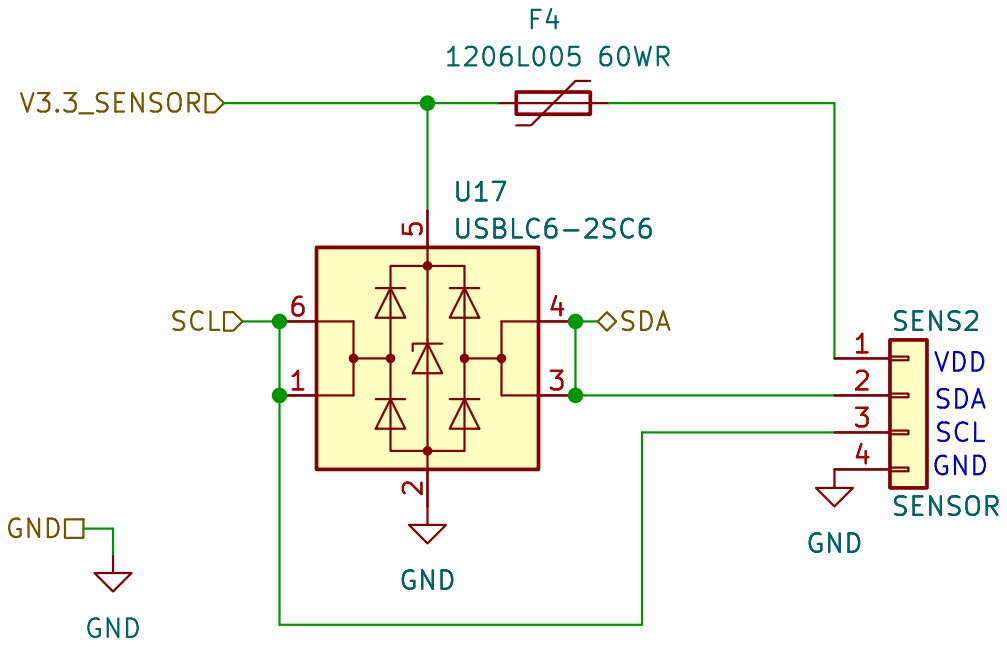
[picture p80: page 13]

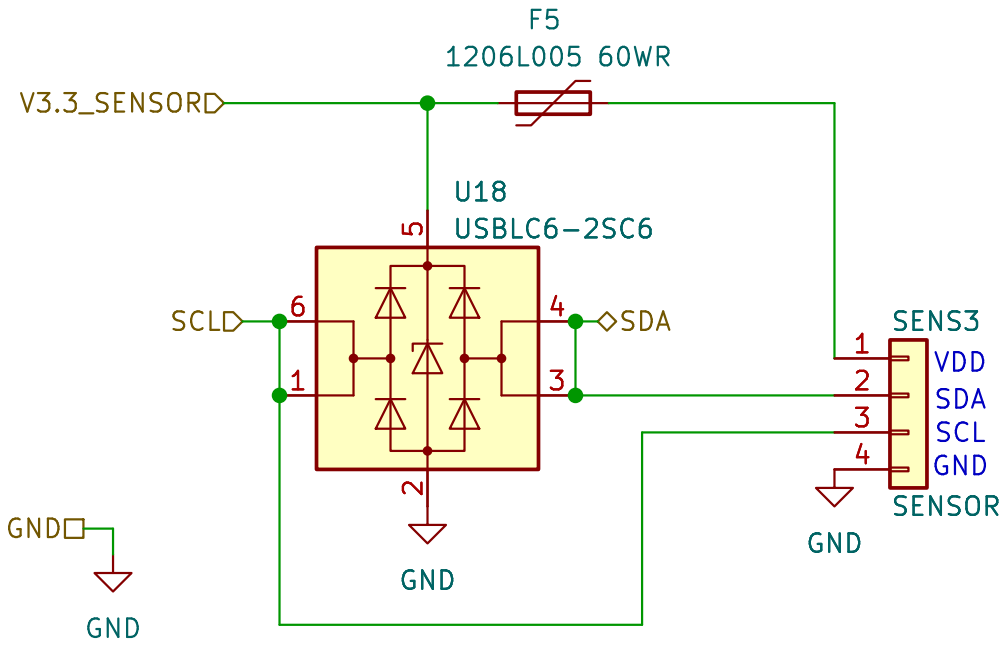
[picture p81: page 14]

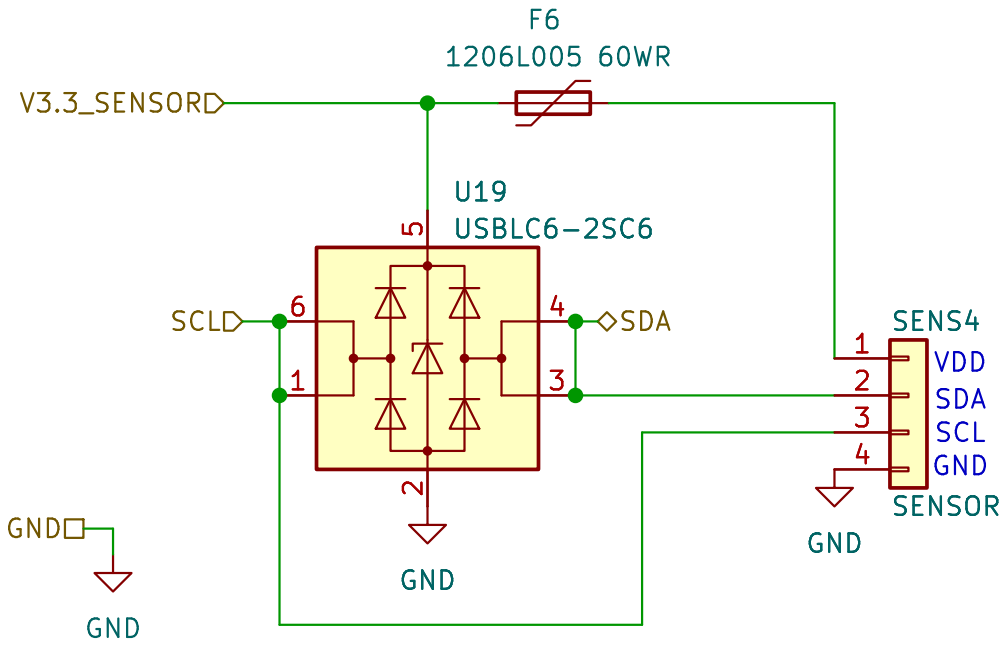
[picture p82: page 15]

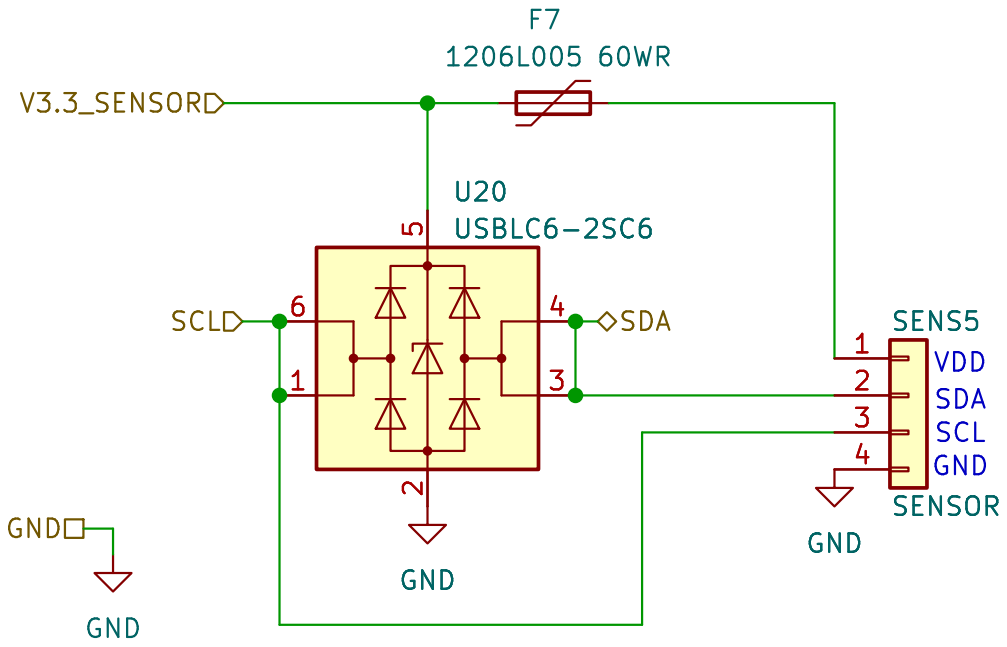
[picture p83: page 16]

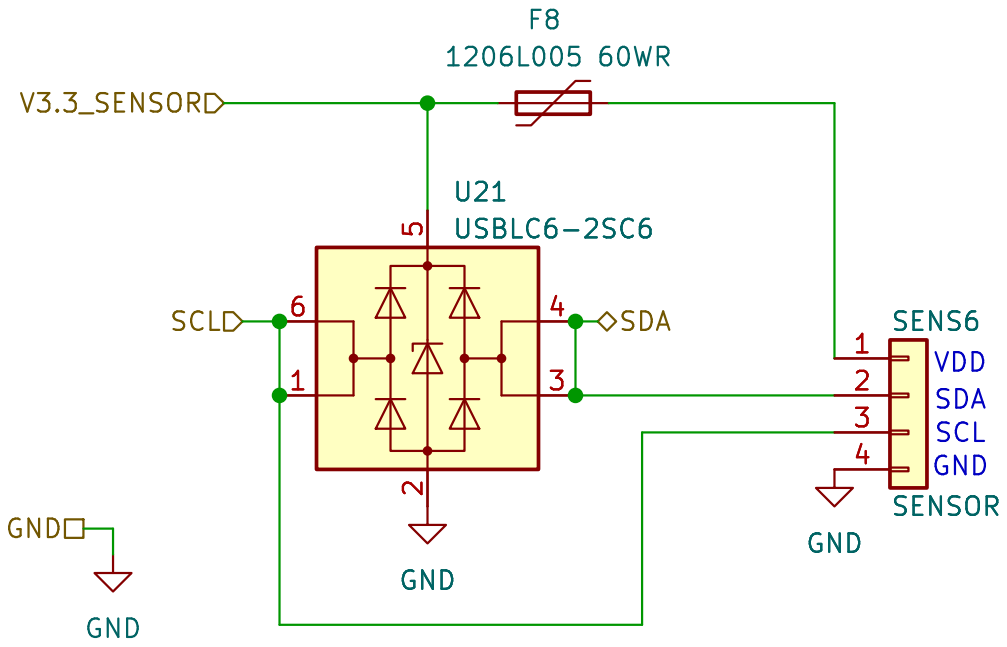
[picture p84: page 17]

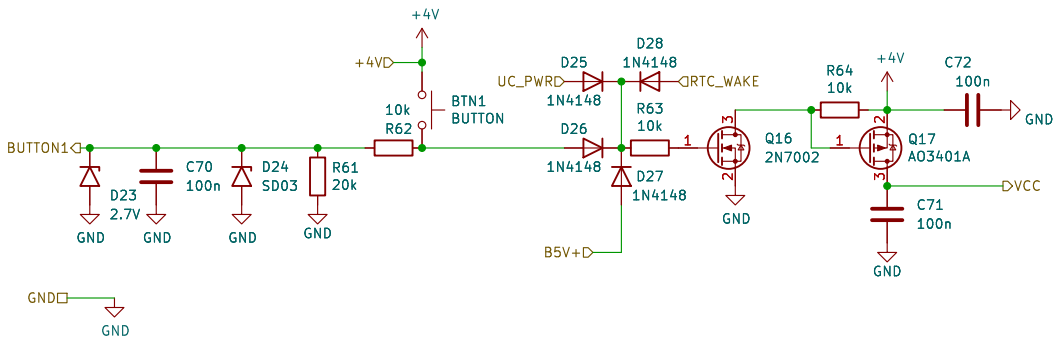
[picture p85: page 18]

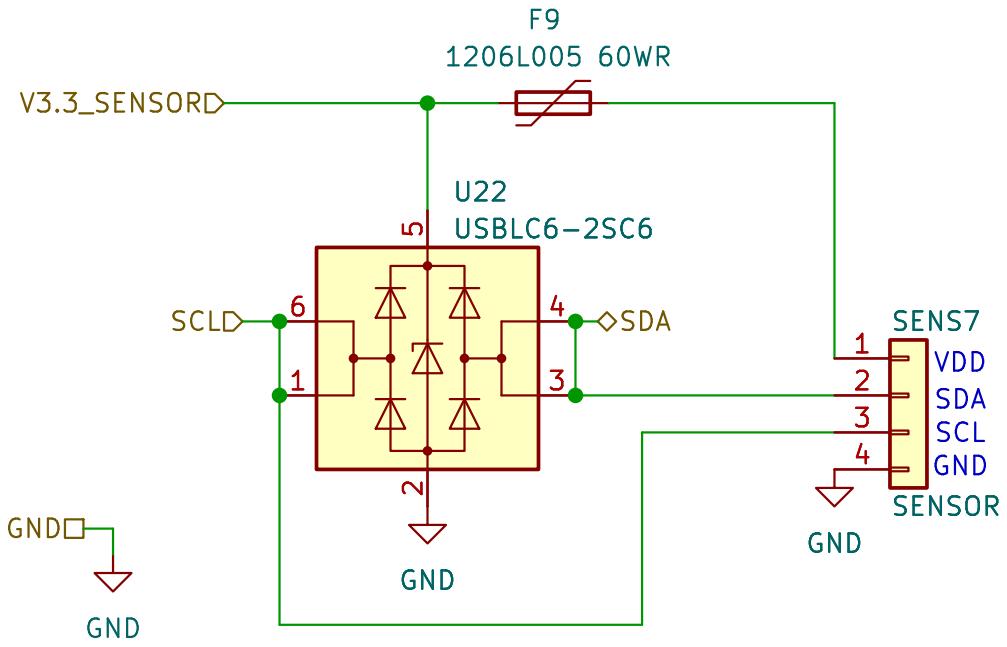
[picture p86: page 19]

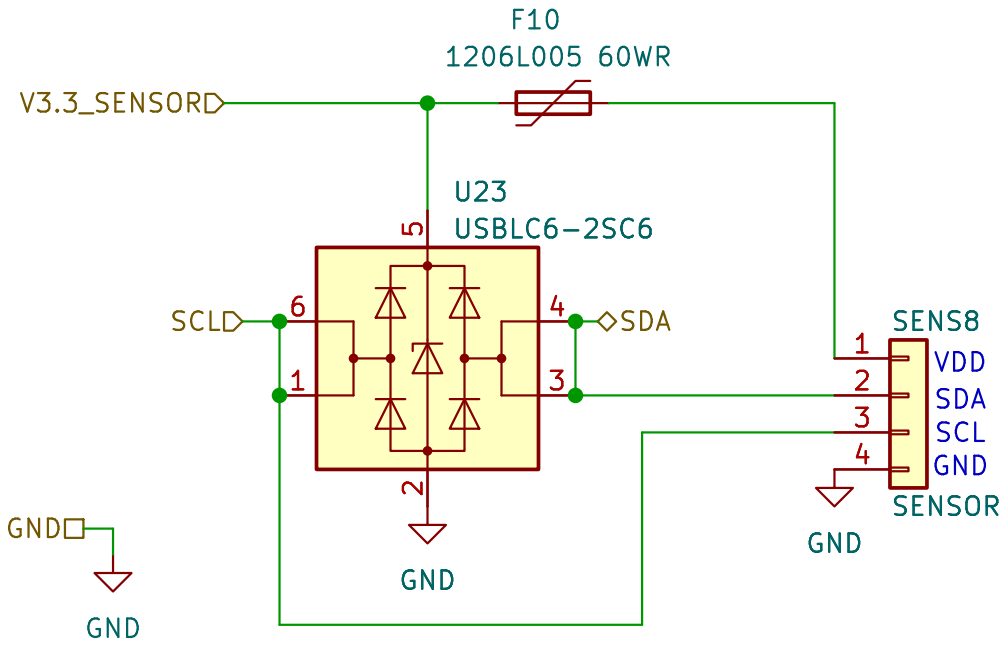
[picture p87: page 20]

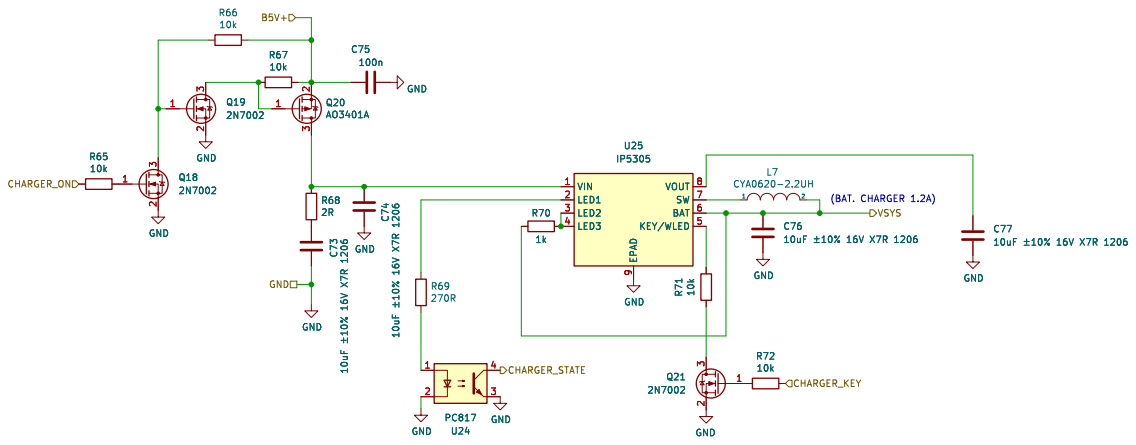
[picture p88: page 21]

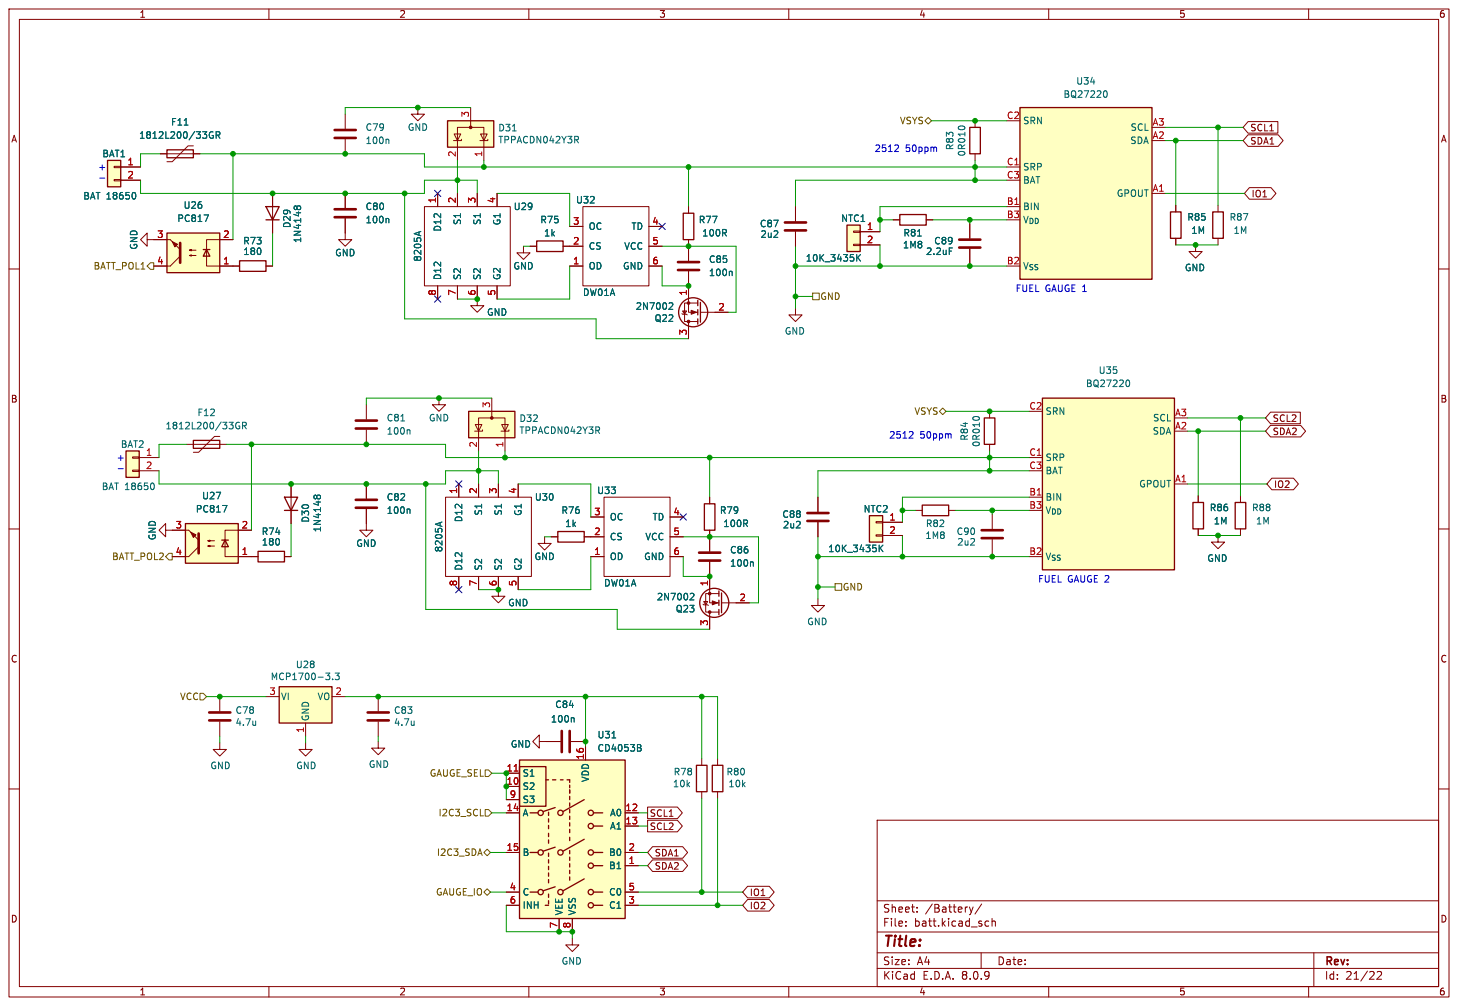
[picture p89: page 22]

8 U30 8205A GPOUT A1 SDA A2 SCL A3 BIN B1 V_{SS} B2 V_{DD} B3 SRP C1 SRN C2 BAT C3 U34 BQ27220
FUEL GAUGE 1 +

Id: 21/22 Title: File: batt.kicad_sch Sheet: /Battery/ R80
