rtek1000/Datalogger_2039/Hardware/TMP117/Datalogger2039_TMP117_adapter/Datalogger2039_TMP117_adapter.pdf

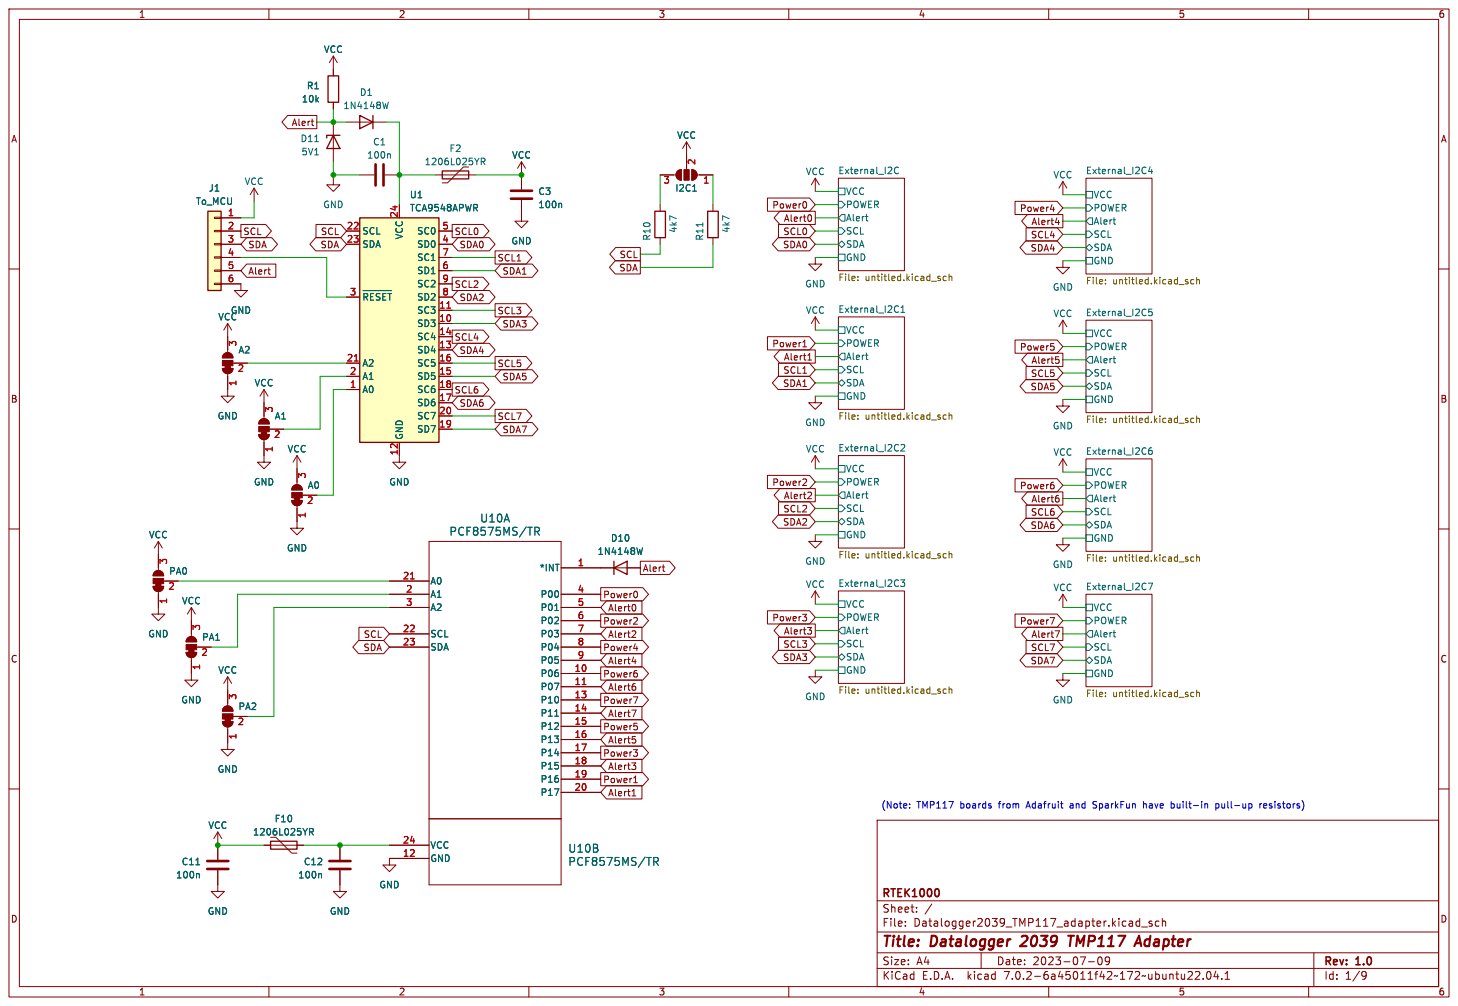
[picture p90: page 1]

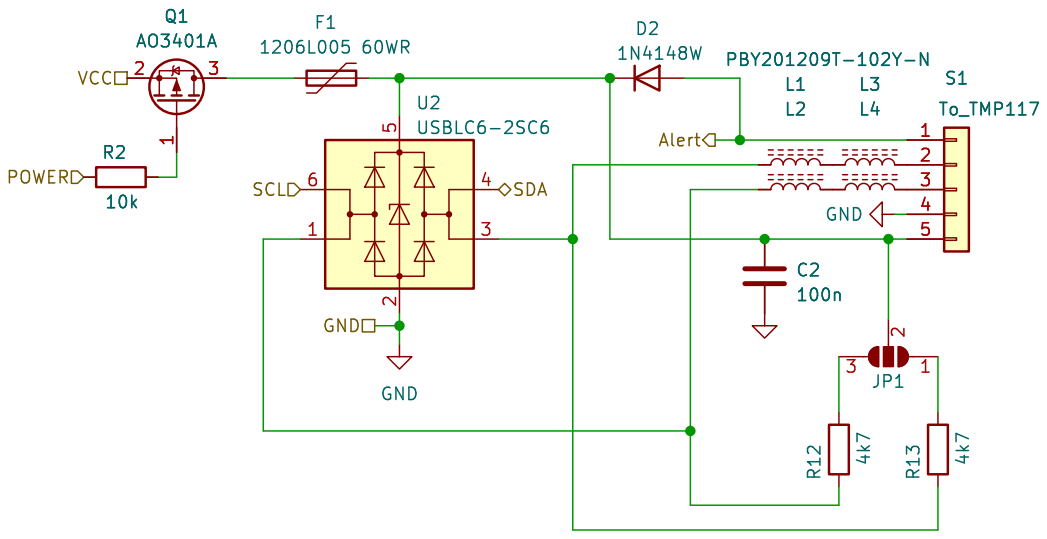
[picture p91: page 2]

Id: 2/9 Title: File: untitled.kicad_sch Sheet: /External_I2C/

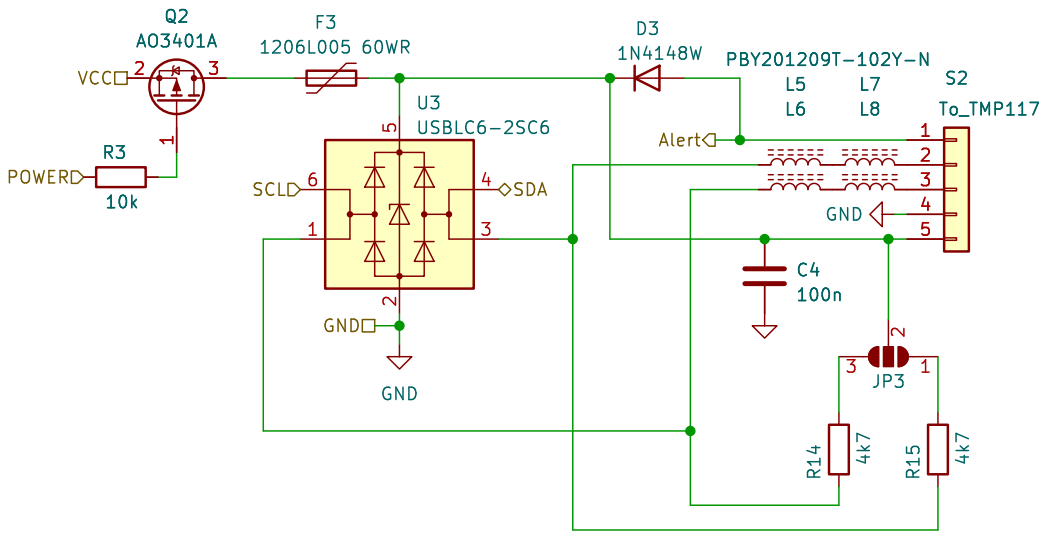
[picture p92: page 3]

Id: 3/9 Title: File: untitled.kicad_sch Sheet: /External_I2C1/

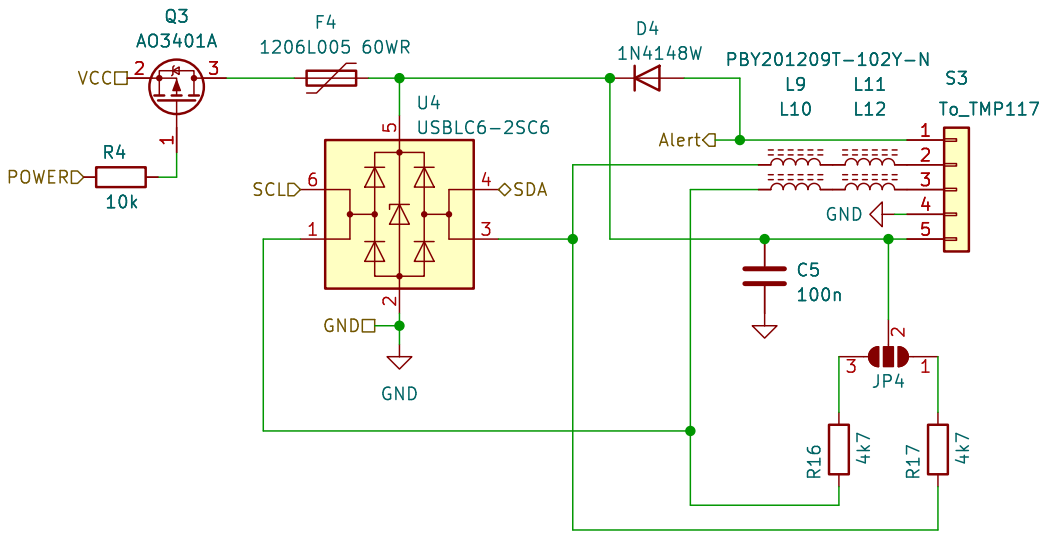
[picture p93: page 4]

Id: 4/9 Title: File: untitled.kicad_sch Sheet: /External_I2C2/

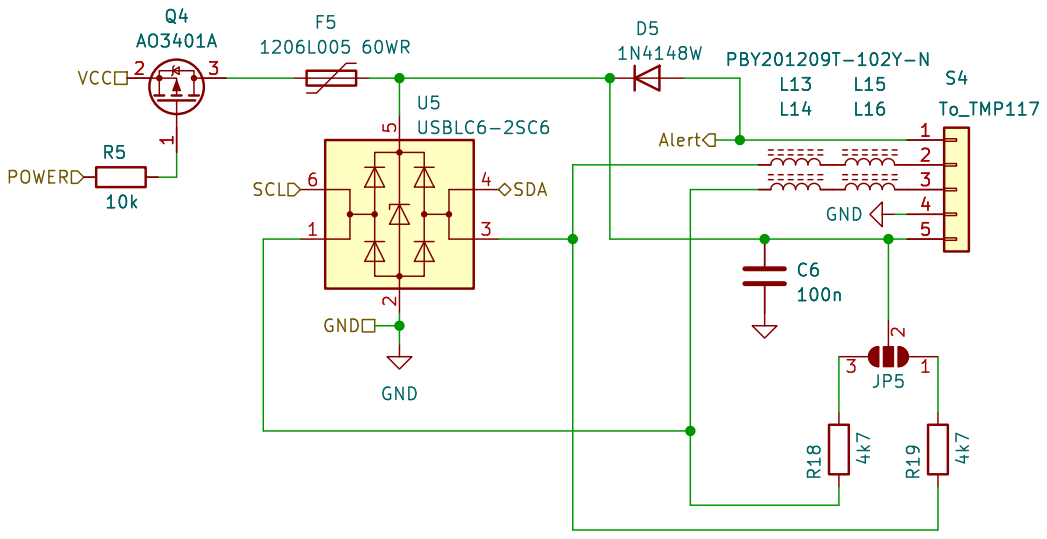
[picture p94: page 5]

Id: 5/9 Title: File: untitled.kicad_sch Sheet: /External_I2C3/

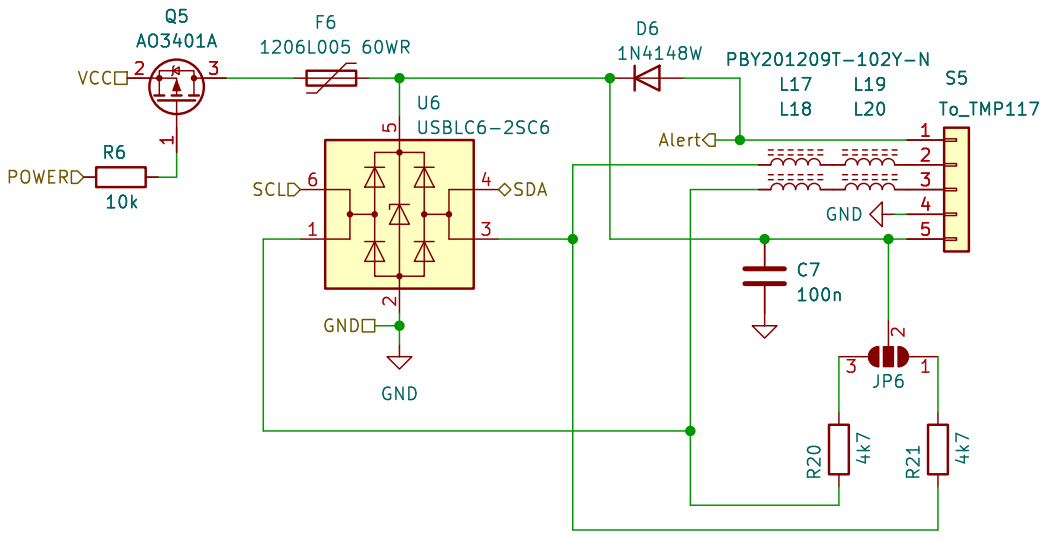
[picture p95: page 6]

Id: 6/9 Title: File: untitled.kicad_sch Sheet: /External_I2C4/

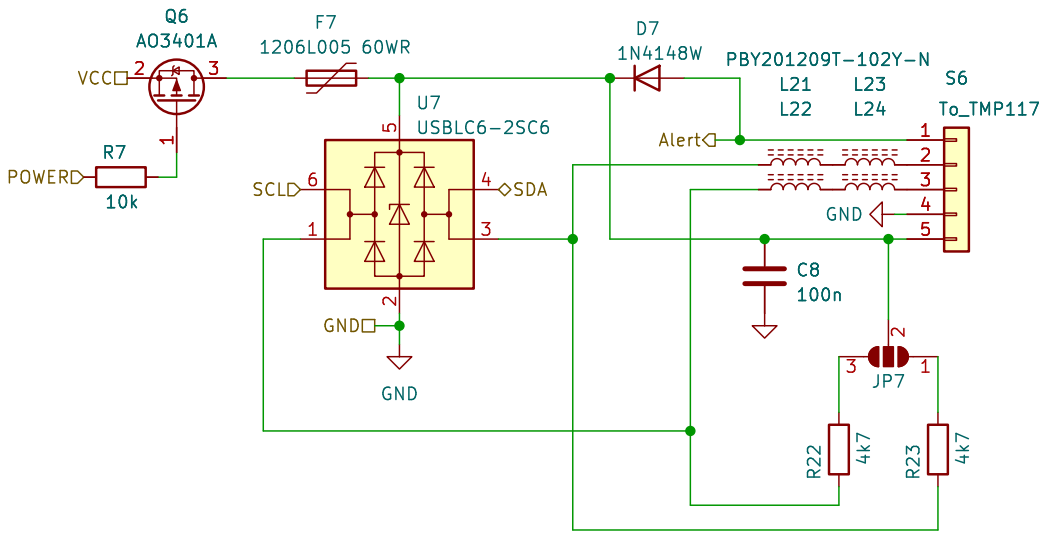
[picture p96: page 7]

Id: 7/9 Title: File: untitled.kicad_sch Sheet: /External_I2C5/

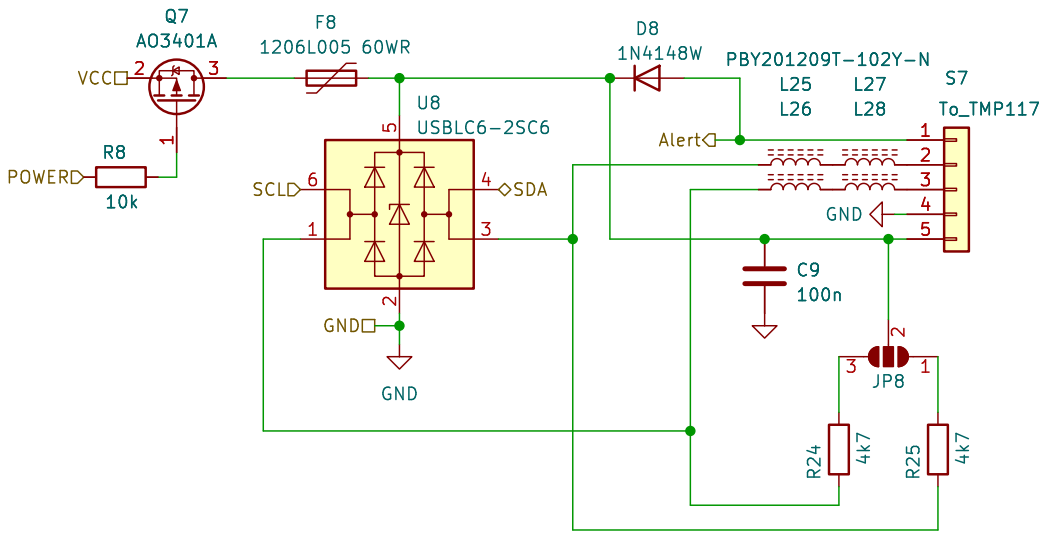
[picture p97: page 8]

Id: 8/9 Title: File: untitled.kicad_sch Sheet: /External_I2C6/

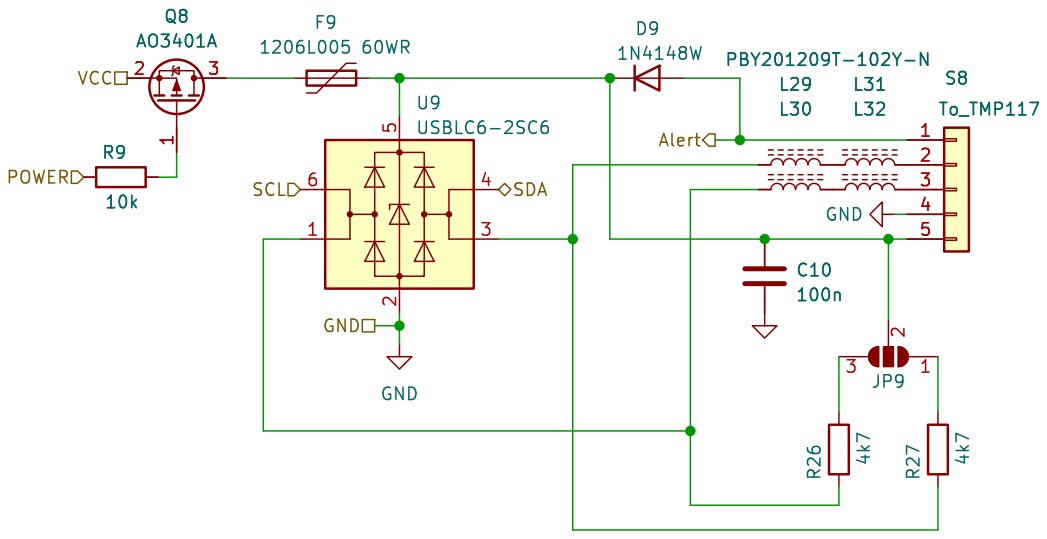
[picture p98: page 9]

Id: 9/9 Title: File: untitled.kicad_sch Sheet: /External_I2C7/
