rtek1000/Datalogger_2039/Hardware/TMP117/TMP117_Custom_Board/TMP117_custom_board/TMP117_custom_board.pdf

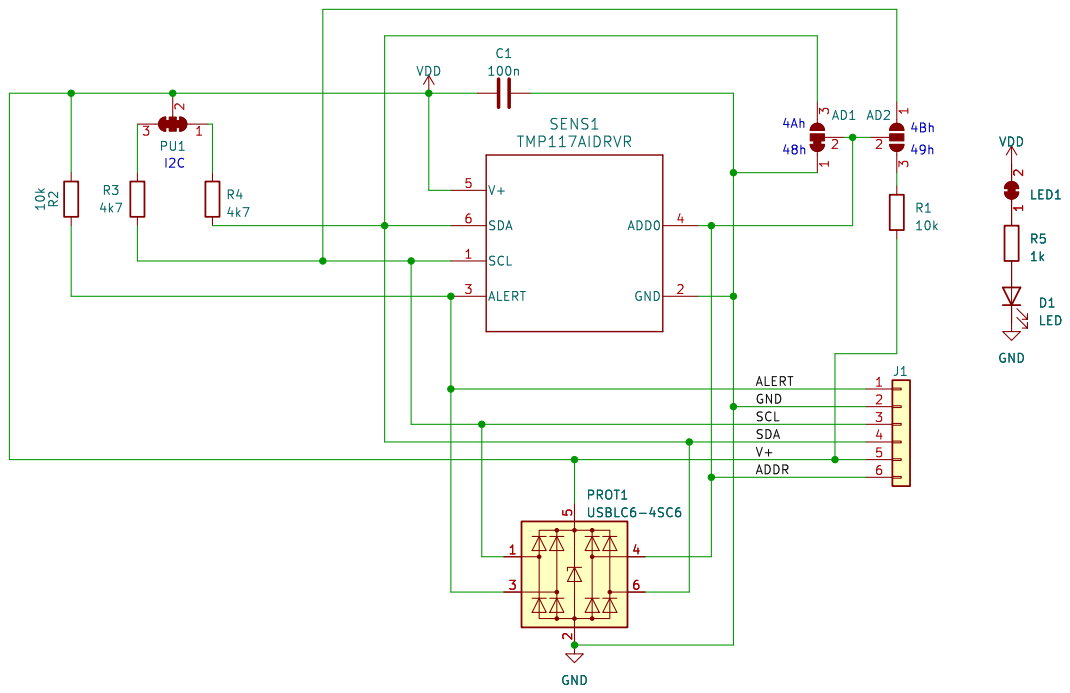
[picture p99: page 1]

SCL ALERT V+ADDR | 3

PROT1 USBLC6-4SC6 | | | 6

Id: 1/1 Title: TMP117 Custom Board
