rtek1000/Datalogger_2039/Hardware/TMP117/Datalogger2039_TMP117_adapter/Datalogger2039_TMP117_adapter.kicad_pcb

## KiCad design Hardware/TMP117/Datalogger2039_TMP117_adapter/Datalogger2039_TMP117_adapter.kicad_pcb (2023-07-09)

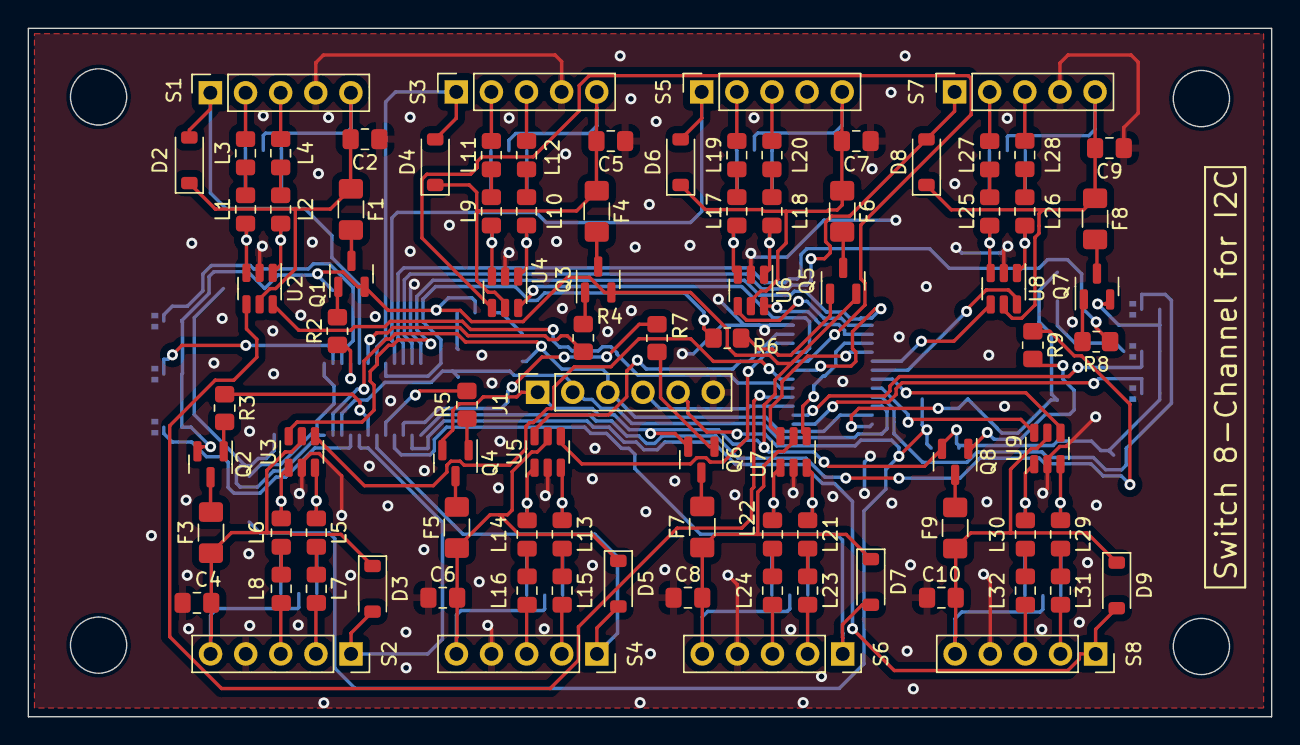
[picture p100: board Datalogger2039_TMP117_adapter.kicad_pcb from above]

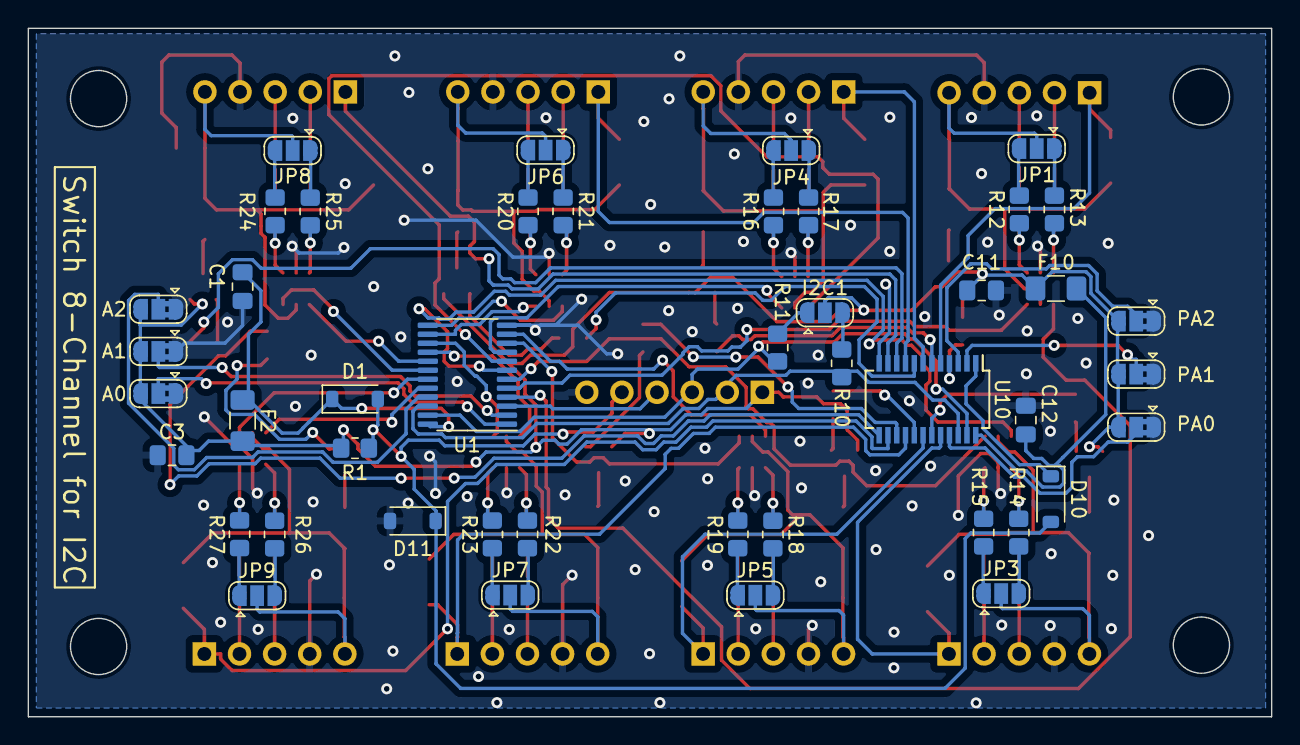
[picture p101: board Datalogger2039_TMP117_adapter.kicad_pcb from below]

Board: 2 copper layers, 89.9 x 49.8 mm, 134 parts (45 on the bottom side), 137 nets.

Parts:
A0: A0; SolderJumper-3_P1.3mm_Bridged2Bar12_RoundedPad1.0x1.5mm
A1: A1; SolderJumper-3_P1.3mm_Bridged2Bar12_RoundedPad1.0x1.5mm
A2: A2; SolderJumper-3_P1.3mm_Bridged2Bar12_RoundedPad1.0x1.5mm
C1, C2, C3, C4, C5, C6, C7, C8, C9, C10, C11, C12: 100n; C_0805_2012Metric_Pad1.18x1.45mm_HandSolder
D1, D2, D3, D4, D5, D6, D7, D8, D9, D10: 1N4148W; D_SOD-123
D11: 5V1; D_SOD-123
F1, F3, F4, F5, F6, F7, F8, F9: 1206L005 60WR; Fuse_1206_3216Metric_Pad1.42x1.75mm_HandSolder
F2, F10: 1206L025YR; Fuse_1206_3216Metric_Pad1.42x1.75mm_HandSolder
I2C1: SolderJumper_3_Open; SolderJumper-3_P1.3mm_Open_RoundedPad1.0x1.5mm
J1: To_MCU; PinSocket_1x06_P2.54mm_Vertical
JP1, JP3, JP4, JP5, JP6, JP7, JP8, JP9: SolderJumper_3_Open; SolderJumper-3_P1.3mm_Open_RoundedPad1.0x1.5mm
L1, L2, L3, L4, L5, L6, L7, L8, L9, L10, L11, L12, L13, L14, L15, L16, L17, L18, L19, L20, L21, L22, L23, L24, L25, L26, L27, L28, L29, L30, L31, L32: PBY201209T-102Y-N; L_0805_2012Metric_Pad1.15x1.40mm_HandSolder
PA0, PA1, PA2: A0; SolderJumper-3_P1.3mm_Bridged2Bar12_RoundedPad1.0x1.5mm
Q1, Q2, Q3, Q4, Q5, Q6, Q7, Q8: AO3401A; SOT-23
R1, R2, R3, R4, R5, R6, R7, R8, R9: 10k; R_0805_2012Metric_Pad1.20x1.40mm_HandSolder
R10, R11, R12, R13, R14, R15, R16, R17, R18, R19, R20, R21, R22, R23, R24, R25, R26, R27: 4k7; R_0805_2012Metric_Pad1.20x1.40mm_HandSolder
S1, S2, S3, S4, S5, S6, S7, S8: To_TMP117; PinSocket_1x05_P2.54mm_Vertical
U1: TCA9548APWR; TSSOP-24_4.4x7.8mm_P0.65mm
U2, U3, U4, U5, U6, U7, U8, U9: USBLC6-2SC6; SOT-23-6
U10: PCF8575MS/TR; SSOP-24_3.9x8.7mm_P0.635mm

Connections:
Alert: D1.2 (A), D10.2 (A), D11.1 (K), J1.5, R1.2
Alert0: D2.2 (A), S1.1, U10.5 (P01)
Alert1: D3.2 (A), S2.1, U10.20 (P17)
Alert2: D4.2 (A), S3.1, U10.7 (P03)
Alert3: D5.2 (A), S4.1, U10.18 (P15)
Alert4: D6.2 (A), S5.1, U10.9 (P05)
Alert5: D7.2 (A), S6.1, U10.16 (P13)
Alert6: D8.2 (A), S7.1, U10.11 (P07)
Alert7: D9.2 (A), S8.1, U10.14 (P11)
GND: A0.1 (A), A1.1 (A), A2.1 (A), C1.1, C2.1, C3.1, C4.1, C5.1, C6.1, C7.1, C8.1, C9.1, C10.1, C11.1, C12.1, D11.2 (A), J1.6, PA0.1 (A), PA1.1 (A), PA2.1 (A), S1.4, S2.4, S3.4, S4.4, S5.4, S6.4, S7.4, S8.4, U1.12 (GND), U2.2 (GND), U3.2 (GND), U4.2 (GND), U5.2 (GND), U6.2 (GND), U7.2 (GND), U8.2 (GND), U9.2 (GND), U10.12 (GND)
unnamed: A0.2 (C), U1.1 (A0)
unnamed: A1.2 (C), U1.2 (A1)
unnamed: A2.2 (C), U1.21 (A2)
unnamed: C1.2, D1.1 (K), F2.1, U1.24 (VCC)
unnamed: C2.2, D2.1 (K), F1.1, JP1.2 (C), S1.5, U2.5 (VBUS)
unnamed: C4.2, D3.1 (K), F3.1, JP3.2 (C), S2.5, U3.5 (VBUS)
unnamed: C5.2, D4.1 (K), F4.1, JP4.2 (C), S3.5, U4.5 (VBUS)
unnamed: C6.2, D5.1 (K), F5.1, JP5.2 (C), S4.5, U5.5 (VBUS)
unnamed: C7.2, D6.1 (K), F6.1, JP6.2 (C), S5.5, U6.5 (VBUS)
unnamed: C8.2, D7.1 (K), F7.1, JP7.2 (C), S6.5, U7.5 (VBUS)
unnamed: C9.2, D8.1 (K), F8.1, JP8.2 (C), S7.5, U8.5 (VBUS)
unnamed: C10.2, D9.1 (K), F9.1, JP9.2 (C), S8.5, U9.5 (VBUS)
unnamed: D10.1 (K), U10.1 (*INT)
unnamed: I2C1.1 (A), R11.2
unnamed: I2C1.3 (B), R10.2
unnamed: J1.4, U1.3 (~RESET)
unnamed: JP1.1 (A), R13.2
unnamed: JP1.3 (B), R12.2
unnamed: JP3.1 (A), R15.2
unnamed: JP3.3 (B), R14.2
unnamed: JP4.1 (A), R17.2
unnamed: JP4.3 (B), R16.2
unnamed: JP5.1 (A), R19.2
unnamed: JP5.3 (B), R18.2
unnamed: JP6.1 (A), R21.2
unnamed: JP6.3 (B), R20.2
unnamed: JP7.1 (A), R23.2
unnamed: JP7.3 (B), R22.2
unnamed: JP8.1 (A), R25.2
unnamed: JP8.3 (B), R24.2
unnamed: JP9.1 (A), R27.2
unnamed: JP9.3 (B), R26.2
unnamed: L1.1, R13.1, U2.3 (I/O2)
unnamed: L1.2, L3.1
unnamed: L2.1, R12.1, U2.1 (I/O1)
unnamed: L2.2, L4.1
unnamed: L5.1, R15.1, U3.3 (I/O2)
unnamed: L5.2, L7.1
unnamed: L6.1, R14.1, U3.1 (I/O1)
unnamed: L6.2, L8.1
unnamed: L9.1, R17.1, U4.3 (I/O2)
unnamed: L10.1, R16.1, U4.1 (I/O1)
unnamed: L10.2, L12.1
unnamed: L9.2, L11.1
unnamed: L13.1, R19.1, U5.3 (I/O2)
unnamed: L13.2, L15.1
unnamed: L14.1, R18.1, U5.1 (I/O1)
unnamed: L14.2, L16.1
unnamed: L17.1, R21.1, U6.3 (I/O2)
unnamed: L17.2, L19.1
unnamed: L18.1, R20.1, U6.1 (I/O1)
unnamed: L18.2, L20.1
unnamed: L21.1, R23.1, U7.3 (I/O2)
unnamed: L21.2, L23.1
unnamed: L22.1, R22.1, U7.1 (I/O1)
unnamed: L22.2, L24.1
unnamed: L25.1, R25.1, U8.3 (I/O2)
unnamed: L25.2, L27.1
unnamed: L26.1, R24.1, U8.1 (I/O1)
unnamed: L26.2, L28.1
unnamed: L29.1, R27.1, U9.3 (I/O2)
unnamed: L29.2, L31.1
unnamed: L30.1, R26.1, U9.1 (I/O1)
unnamed: L30.2, L32.1
unnamed: PA0.2 (C), U10.21 (A0)
unnamed: PA1.2 (C), U10.2 (A1)
unnamed: PA2.2 (C), U10.3 (A2)
unnamed: F1.2, Q1.3 (D)
unnamed: Q1.1 (G), R2.2
unnamed: F3.2, Q2.3 (D)
unnamed: Q2.1 (G), R3.2
unnamed: F4.2, Q3.3 (D)
unnamed: Q3.1 (G), R4.2
unnamed: F5.2, Q4.3 (D)
unnamed: Q4.1 (G), R5.2
unnamed: F6.2, Q5.3 (D)
unnamed: Q5.1 (G), R6.2
unnamed: F7.2, Q6.3 (D)
unnamed: Q6.1 (G), R7.2
unnamed: F8.2, Q7.3 (D)
unnamed: Q7.1 (G), R8.2
unnamed: F9.2, Q8.3 (D)
unnamed: Q8.1 (G), R9.2
unnamed: L3.2, S1.2
unnamed: L4.2, S1.3
unnamed: L7.2, S2.2
unnamed: L8.2, S2.3
unnamed: L11.2, S3.2
unnamed: L12.2, S3.3
unnamed: L15.2, S4.2
unnamed: L16.2, S4.3
unnamed: L19.2, S5.2
unnamed: L20.2, S5.3
unnamed: L23.2, S6.2
unnamed: L24.2, S6.3
unnamed: L27.2, S7.2
unnamed: L28.2, S7.3
unnamed: L31.2, S8.2
unnamed: L32.2, S8.3
unnamed: C12.2, F10.1, U10.24 (VCC)
Power0: R2.1, U10.4 (P00)
Power1: R3.1, U10.19 (P16)
Power2: R4.1, U10.6 (P02)
Power3: R5.1, U10.17 (P14)
Power4: R6.1, U10.8 (P04)
Power5: R7.1, U10.15 (P12)
Power6: R8.1, U10.10 (P06)
Power7: R9.1, U10.13 (P10)
SCL: J1.2, R10.1, U1.22 (SCL), U10.22 (SCL)
SCL0: U1.5 (SC0), U2.6 (I/O1)
SCL1: U1.7 (SC1), U3.6 (I/O1)
SCL2: U1.9 (SC2), U4.6 (I/O1)
SCL3: U1.11 (SC3), U5.6 (I/O1)
SCL4: U1.14 (SC4), U6.6 (I/O1)
SCL5: U1.16 (SC5), U7.6 (I/O1)
SCL6: U1.18 (SC6), U8.6 (I/O1)
SCL7: U1.20 (SC7), U9.6 (I/O1)
SDA: J1.3, R11.1, U1.23 (SDA), U10.23 (SDA)
SDA0: U1.4 (SD0), U2.4 (I/O2)
SDA1: U1.6 (SD1), U3.4 (I/O2)
SDA2: U1.8 (SD2), U4.4 (I/O2)
SDA3: U1.10 (SD3), U5.4 (I/O2)
SDA4: U1.13 (SD4), U6.4 (I/O2)
SDA5: U1.15 (SD5), U7.4 (I/O2)
SDA6: U1.17 (SD6), U8.4 (I/O2)
SDA7: U1.19 (SD7), U9.4 (I/O2)
VCC: A0.3 (B), A1.3 (B), A2.3 (B), C3.2, C11.2, F2.2, F10.2, I2C1.2 (C), J1.1, PA0.3 (B), PA1.3 (B), PA2.3 (B), Q1.2 (S), Q2.2 (S), Q3.2 (S), Q4.2 (S), Q5.2 (S), Q6.2 (S), Q7.2 (S), Q8.2 (S), R1.1
