rtek1000/Datalogger_2039/Hardware/TMP117/TMP117_Custom_Board/TMP117_custom_board/TMP117_custom_board.kicad_pcb

## KiCad design Hardware/TMP117/TMP117_Custom_Board/TMP117_custom_board/TMP117_custom_board.kicad_pcb (2023-07-09)

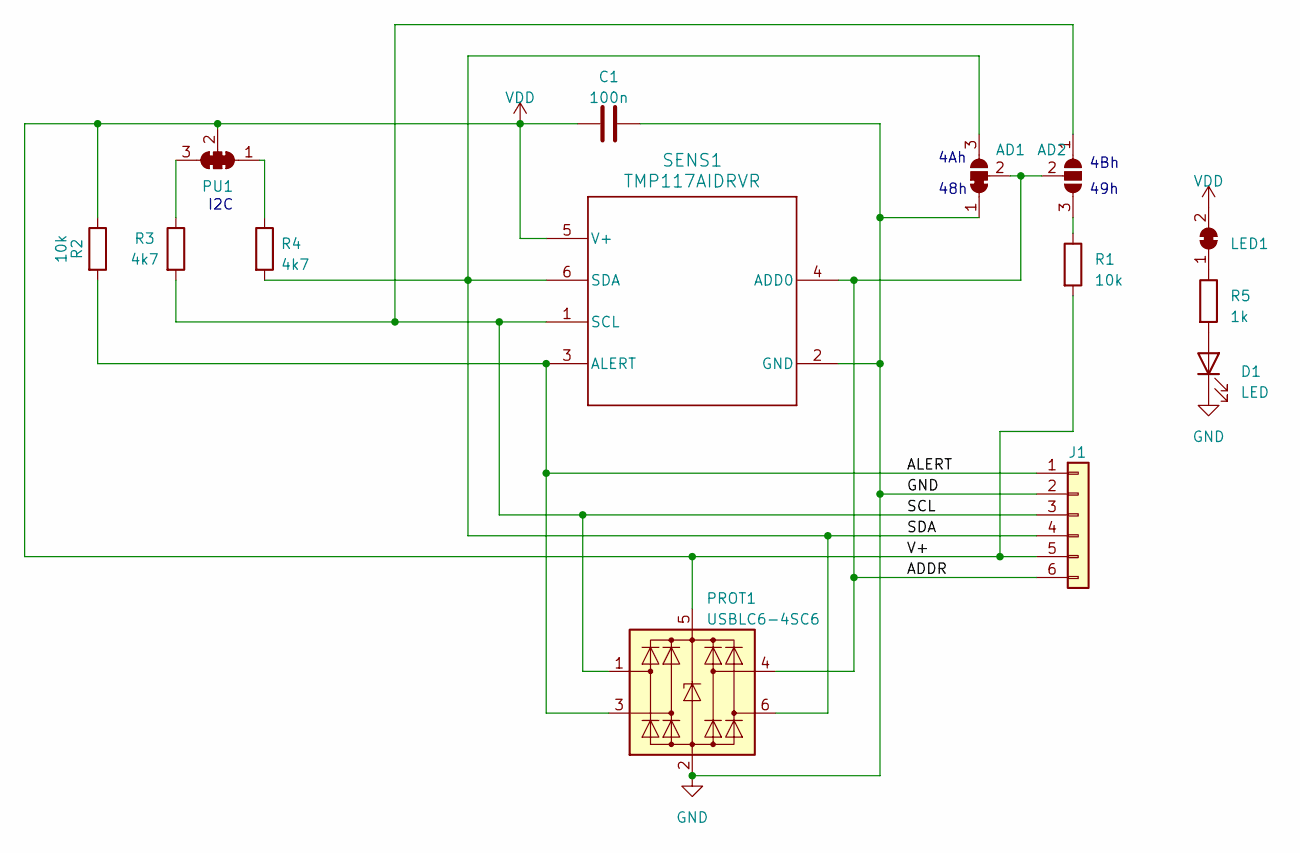
[picture p102: schematic TMP117_custom_board.kicad_sch]

Parts:
AD1: SolderJumper_3_Bridged12; SolderJumper-3_P1.3mm_Bridged12_RoundedPad1.0x1.5mm
AD2: SolderJumper_3_Open; SolderJumper-3_P1.3mm_Open_RoundedPad1.0x1.5mm
C1: 100n; C_0402_1005Metric_Pad0.74x0.62mm_HandSolder; LCSC Part C387941
D1: LED; LED_0603_1608Metric_Pad1.05x0.95mm_HandSolder; LCSC Part C2837379
J1: Conn_01x06; PinHeader_1x06_P2.54mm_Vertical
LED1: SolderJumper_2_Bridged; SolderJumper-2_P1.3mm_Bridged_RoundedPad1.0x1.5mm
PROT1: USBLC6-4SC6; SOT-23-6; LCSC Part C111212
PU1: SolderJumper_3_Bridged123; SolderJumper-3_P1.3mm_Bridged123_RoundedPad1.0x1.5mm
R1, R2: 10k; R_0603_1608Metric_Pad0.98x0.95mm_HandSolder; LCSC Part C116677
R3, R4: 4k7; R_0603_1608Metric_Pad0.98x0.95mm_HandSolder; LCSC Part C3016318
R5: 1k; R_0603_1608Metric_Pad0.98x0.95mm_HandSolder; LCSC Part C3016283
SENS1: TMP117AIDRVR; DRV0006B2; LCSC Part C699536

Connections:
/ADDR: AD1.2 (C), AD2.2 (C), J1.6, PROT1.4 (I/O3), SENS1.4 (ADD0)
/ALERT: J1.1, PROT1.3 (I/O2), R2.2, SENS1.3 (ALERT)
/SCL: AD2.1 (A), J1.3, PROT1.1 (I/O1), R3.2, SENS1.1 (SCL)
/SDA: AD1.3 (B), J1.4, PROT1.6 (I/O4), R4.2, SENS1.6 (SDA)
GND: AD1.1 (A), C1.2, D1.1 (K), J1.2, PROT1.2 (GND), SENS1.2 (GND)
unnamed: AD2.3 (B), R1.1
unnamed: D1.2 (A), R5.2
unnamed: LED1.1 (A), R5.1
unnamed: PU1.1 (A), R4.1
unnamed: PU1.3 (B), R3.1
VDD: C1.1, J1.5, LED1.2 (B), PROT1.5 (VBUS), PU1.2 (C), R1.2, R2.1, SENS1.5 (V+)

Notes on the sheet:
I2C
48h
4Bh
4Ah
49h

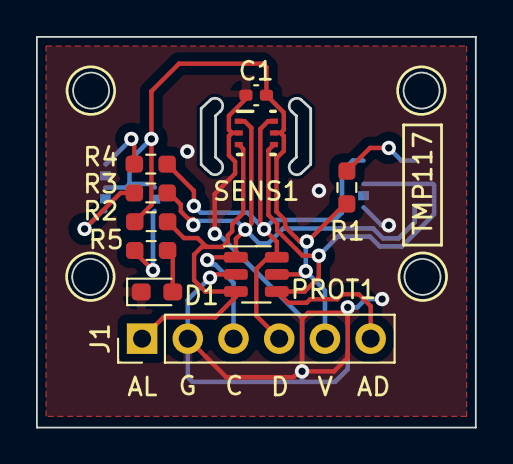
[picture p103: board TMP117_custom_board.kicad_pcb from above]

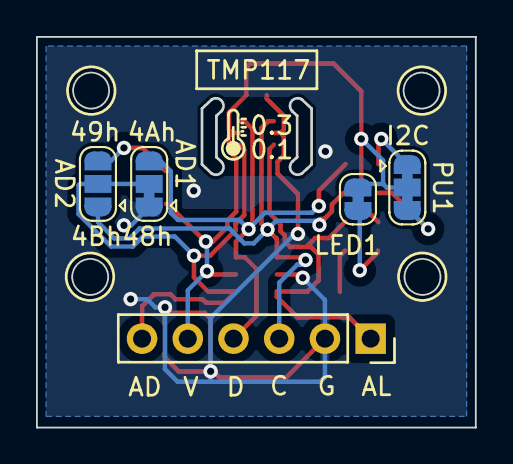
[picture p104: board TMP117_custom_board.kicad_pcb from below]

Board: 2 copper layers, 24.4 x 21.7 mm, 14 parts (4 on the bottom side), 11 nets.
