rtek1000/Datalogger_2039/Software/Datalogger_2039 - STM32/Datalogger2039_USB_Host_HID/Core/Src/main.c

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
/* Includes ------------------------------------------------------------------*/
#include "main.h"
#include "usb_host.h"

/* USER CODE BEGIN Includes */
#include <stdio.h>
/* USER CODE END Includes */

UART_HandleTypeDef huart1;

/* USER CODE BEGIN PV */
uint32_t usb_failure_timeout = 0;
uint32_t usb_failure_timeout2 = 0;
uint32_t usb_failure_timeout3 = 0;
uint32_t usb1_failure_cnt = 0;
uint32_t usb1_fail_freq = 0;
uint8_t usb1_failure_flag = 0;
uint8_t usb1_failure_flag_old = 0;
/* USER CODE END PV */

void SystemClock_Config(void);
static void MX_GPIO_Init(void);
static void MX_USART1_UART_Init(void);
void MX_USB_HOST_Process(void);

/* USER CODE BEGIN PFP */
int __io_putchar(int ch);
int _write(int file, char *ptr, int len);
void HAL_GPIO_EXTI_Callback(uint16_t GPIO_Pin);
void beep(void);
/* USER CODE END PFP */

/**
  * @brief  The application entry point.
  * @retval int
  */
int main(void)
{
  /* MCU Configuration--------------------------------------------------------*/

  /* Reset of all peripherals, Initializes the Flash interface and the Systick. */
  HAL_Init();

  /* Configure the system clock */
  SystemClock_Config();

  /* Initialize all configured peripherals */
  MX_GPIO_Init();
  MX_USART1_UART_Init();
  MX_USB_HOST_Init();
  /* USER CODE BEGIN 2 */
	beep();
  /* USER CODE END 2 */

  /* Infinite loop */
  /* USER CODE BEGIN WHILE */
	while (1) {
    /* USER CODE END WHILE */
    MX_USB_HOST_Process();

    /* USER CODE BEGIN 3 */
		if ((usb_failure_timeout2 + 100) < HAL_GetTick()) {
			usb_failure_timeout2 = HAL_GetTick();
			if ((usb1_failure_flag == 1) && (usb1_failure_flag_old == 0)) {
				usb1_failure_flag_old = 1;
				//UsrLog("USB2 Power fail (interrupt freq: %lu)", usb2_fail_freq);
				UsrLog("USB2 Power fail: Deactivating power");
				HAL_GPIO_WritePin(USB_FS_PWR_GPIO_Port, USB_FS_PWR_Pin,
						GPIO_PIN_SET);
			}

			if ((usb_failure_timeout3 + 5000) < HAL_GetTick()) {
				usb_failure_timeout3 = HAL_GetTick();

				if ((usb1_failure_flag == 0) && (usb1_failure_flag_old == 1)) {
					usb1_failure_flag_old = 0;
					UsrLog("Reactivating power");
					HAL_GPIO_WritePin(USB_FS_PWR_GPIO_Port, USB_FS_PWR_Pin,
							GPIO_PIN_RESET);
				}
			}
		}
	}
  /* USER CODE END 3 */
}

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
/* USER CODE BEGIN 4 */
int __io_putchar(int ch) {
	uint8_t c[1];
	c[0] = ch & 0x00FF;
	HAL_UART_Transmit(&huart1, &*c, 1, 10);
	return ch;
}

int _write(int file, char *ptr, int len) {
	int DataIdx;
	for (DataIdx = 0; DataIdx < len; DataIdx++) {
		__io_putchar(*ptr++);
	}
	return len;
}

/* Handle interrupt */
// EXTI Line External Interrupt ISR Handler CallBackFun
void HAL_GPIO_EXTI_Callback(uint16_t GPIO_Pin) {
	if (GPIO_Pin == GPIO_PIN_7) // If The INT Source Is EXTI Line7 (PD7 Pin)
	{
		HAL_GPIO_TogglePin(LED2_GPIO_Port, LED2_Pin); // Toggle The Output (LED) Pin
		usb1_failure_cnt++;
		//UsrLog("USB2 Power fail"); usb2_failure_flag
	}
}

void beep(void) {
	HAL_GPIO_WritePin(BUZZER_GPIO_Port, BUZZER_Pin, GPIO_PIN_SET);
	HAL_Delay(5);
	HAL_GPIO_WritePin(BUZZER_GPIO_Port, BUZZER_Pin, GPIO_PIN_RESET);
}
/* USER CODE END 4 */
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
