rtek1000/Datalogger_2039/Software/Datalogger_2039 - STM32/Datalogger2039_USB_Host_MSC/Core/Inc/main.h

#define BUZZER_Pin GPIO_PIN_2
#define BUZZER_GPIO_Port GPIOE
#define DC_DC_ON_Pin GPIO_PIN_3
#define DC_DC_ON_GPIO_Port GPIOE
#define USB_HS_PWR_Pin GPIO_PIN_8
#define USB_HS_PWR_GPIO_Port GPIOD
#define USB_HS_OC_Pin GPIO_PIN_9
#define USB_HS_OC_GPIO_Port GPIOD
#define USB_HS_OC_EXTI_IRQn EXTI9_5_IRQn
#define BUTTON1_Pin GPIO_PIN_11
#define BUTTON1_GPIO_Port GPIOD
#define BUTTON1_EXTI_IRQn EXTI15_10_IRQn
#define BUTTON2_Pin GPIO_PIN_15
#define BUTTON2_GPIO_Port GPIOD
#define BUTTON2_EXTI_IRQn EXTI15_10_IRQn
#define UC_PWR_Pin GPIO_PIN_2
#define UC_PWR_GPIO_Port GPIOD
#define LED2_Pin GPIO_PIN_0
#define LED2_GPIO_Port GPIOE
