rtek1000/Datalogger_2039/Software/Datalogger_2039 - STM32/Datalogger2039_ADC_Test/Core/Src/main.c

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
/* Includes ------------------------------------------------------------------*/
#include "main.h"

/* USER CODE BEGIN Includes */
#include <stdio.h>
#include "stm32f4xx_hal_adc_ex.h"
/* USER CODE END Includes */

ADC_HandleTypeDef hadc1;
ADC_HandleTypeDef hadc2;
ADC_HandleTypeDef hadc3;

UART_HandleTypeDef huart1;

/* USER CODE BEGIN PV */
uint32_t TP4056_charger_freq = 0;
uint32_t AD1_RES_ADC_DC_DC_5V = 0;
uint32_t AD2_RES_ADC_CHARGER = 0;
uint32_t AD3_RES_ADC_VBAT = 0;
uint32_t AD1_RES_ADC_VREF = 0;

/* ADC const calibration */
float const_adc_x2 = 0;
float const_adc_x16 = 0;

float batt_percent_up = 0;
float batt_percent_down = 100;

uint32_t battery_failure_timeout = 0;
volatile uint32_t battery_failure_cnt = 0;
volatile HAL_StatusTypeDef battery_failure_flag = HAL_OK;
/* USER CODE END PV */

void SystemClock_Config(void);
static void MX_GPIO_Init(void);
static void MX_ADC1_Init(void);
static void MX_ADC2_Init(void);
static void MX_ADC3_Init(void);
static void MX_USART1_UART_Init(void);
/* USER CODE BEGIN PFP */
void get_ADC_Vref(void);
float map(float x, float in_min, float in_max, float out_min, float out_max);
/* USER CODE END PFP */

/* USER CODE BEGIN 0 */
float map(float x, float in_min, float in_max, float out_min, float out_max) {
	if ((in_max - in_min) > (out_max - out_min)) {
		return (x - in_min) * (out_max - out_min + 1) / (in_max - in_min + 1)
				+ out_min;
	} else {
		return (x - in_min) * (out_max - out_min) / (in_max - in_min) + out_min;
	}
}
/* USER CODE END 0 */

/**
 * @brief  The application entry point.
 * @retval int
 */
int main(void) {
	/* MCU Configuration--------------------------------------------------------*/

	/* Reset of all peripherals, Initializes the Flash interface and the Systick. */
	HAL_Init();

	/* Configure the system clock */
	SystemClock_Config();

	/* Initialize all configured peripherals */
	MX_GPIO_Init();
	MX_ADC1_Init();
	MX_ADC2_Init();
	MX_ADC3_Init();
	MX_USART1_UART_Init();
	/* USER CODE BEGIN 2 */
	HAL_Delay(50);

	get_ADC_Vref();

	HAL_GPIO_WritePin(DC_DC_ON_GPIO_Port, DC_DC_ON_Pin, GPIO_PIN_SET);

	/* USER CODE END 2 */

	/* Infinite loop */
	/* USER CODE BEGIN WHILE */
	while (1) {
		/* USER CODE END WHILE */

		/* USER CODE BEGIN 3 */
		get_ADC_Vref();

		AD1_RES_ADC_DC_DC_5V = 0;
		AD2_RES_ADC_CHARGER = 0;
		AD3_RES_ADC_VBAT = 0;

		for (int i = 0; i < 50; i++) {
			// Start ADC Conversion
			HAL_ADC_Start(&hadc1);
			HAL_ADC_Start(&hadc2);
			HAL_ADC_Start(&hadc3);
			// Poll ADC1 Perihperal & TimeOut = 1mSec
			HAL_ADC_PollForConversion(&hadc1, 1);
			HAL_ADC_PollForConversion(&hadc2, 1);
			HAL_ADC_PollForConversion(&hadc3, 1);
			// Read The ADC Conversion Result & Map It To PWM DutyCycle
			AD1_RES_ADC_DC_DC_5V += HAL_ADC_GetValue(&hadc1);
			AD2_RES_ADC_CHARGER += HAL_ADC_GetValue(&hadc2);
			AD3_RES_ADC_VBAT += HAL_ADC_GetValue(&hadc3);
		}

		float f_adc1 = 0, f_adc2 = 0, f_adc3 = 0; //, f_vref = 0;

		f_adc1 = AD1_RES_ADC_DC_DC_5V / 50;
		f_adc2 = AD2_RES_ADC_CHARGER / 50;
		f_adc3 = AD3_RES_ADC_VBAT / 50;

		// (3.3 / 4096) = 0,000805664
		// R1=10k; R2=10k
		// 3.3V=10k; 20k=2*3.3
		// 0,000805664 * 2 = 0,001611328
		// 0,001611328 * 0,916996047 = 0,001477581
		// R1=15k; R2=1k
		// 3.3V=1k; 16k=16*3.3
		// 0,000805664 * 16 = 0,012890624
		// 0,012890624 * 0,916996047 = 0,011820651

		f_adc1 = f_adc1 * const_adc_x2;
		f_adc2 = f_adc2 * const_adc_x16;
		f_adc3 = f_adc3 * const_adc_x2;

		UsrLog("ADC1 %0.1fV, ADC2 %0.1fV, ADC3 %0.1fV", f_adc1, f_adc2, f_adc3);
		UsrLog("TP4056 LED CHRG freq: %lu", TP4056_charger_freq);

		// battery_failure_flag:
		// interruption on pin PA5 (frequency counter)
		// ---> see stm32f4xx_it.c file

		if (battery_failure_flag == 1) {
			UsrLog("Battery: error; tick: %lu", HAL_GetTick());
		} else {
			if (HAL_GPIO_ReadPin(CHARGER_STATE_GPIO_Port, CHARGER_STATE_Pin)
					== GPIO_PIN_RESET) {
				if (f_adc2 < 8.0) {
					UsrLog("Battery: in use; tick: %lu", HAL_GetTick());

					batt_percent_up = 0.0;
				} else {
					UsrLog("Battery: charging; tick: %lu", HAL_GetTick());
				}
			} else {
				UsrLog("Battery: charged; tick: %lu", HAL_GetTick());
			}
		}

		HAL_Delay(2000);
	}
	/* USER CODE END 3 */
}

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
/* USER CODE BEGIN 4 */
int __io_putchar(int ch) {
	uint8_t c[1];
	c[0] = ch & 0x00FF;
	HAL_UART_Transmit(&huart1, &*c, 1, 10);
	return ch;
}

int _write(int file, char *ptr, int len) {
	int DataIdx;
	for (DataIdx = 0; DataIdx < len; DataIdx++) {
		__io_putchar(*ptr++);
	}
	return len;
}

/* Handle PA5 interrupt */
// EXTI Line5 External Interrupt ISR Handler CallBackFun
void HAL_GPIO_EXTI_Callback(uint16_t GPIO_Pin) {
	if (GPIO_Pin == GPIO_PIN_5) // If The INT Source Is EXTI Line5 (PA5 Pin)
	{
		battery_failure_cnt++;

		HAL_GPIO_TogglePin(LED2_GPIO_Port, LED2_Pin); // Toggle The Output (LED) Pin
	}
}

void get_ADC_Vref(void) {
	// Set ADC Channel 6 (PA6)
	hadc1.Instance->SQR3 = ADC_CHANNEL_6;

	AD1_RES_ADC_VREF = 0;

	for (int i = 0; i < 25; i++) {
		// Start ADC Conversion
		HAL_ADC_Start(&hadc1);
		// Poll ADC1 Perihperal & TimeOut = 1mSec
		HAL_ADC_PollForConversion(&hadc1, 1);
		// Read The ADC Conversion Result & Map It To PWM DutyCycle
		AD1_RES_ADC_VREF += HAL_ADC_GetValue(&hadc1);

		HAL_Delay(1);
	}

	// Set ADC Channel 4 (PA4)
	hadc1.Instance->SQR3 = ADC_CHANNEL_4;

	AD1_RES_ADC_VREF /= 25;

	UsrLog("%lu", AD1_RES_ADC_VREF);

	float f_vref = AD1_RES_ADC_VREF;

	f_vref = 2.495 / f_vref;

	// (3.3 / 4096) = 0,000805664
	// R1=10k; R2=10k
	// 3.3V=10k; 20k=2*3.3
	// 0,000805664 * 2 = 0,001611328
	// 0,001611328 * 0,916996047 = 0,001477581
	// R1=15k; R2=1k
	// 3.3V=1k; 16k=16*3.3
	// 0,000805664 * 16 = 0,012890624
	// 0,012890624 * 0,916996047 = 0,011820651

	const_adc_x2 = (f_vref * 2);
	const_adc_x16 = (f_vref * 16);
}
/* USER CODE END 4 */
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
