rtek1000/Datalogger_2039/Software/Datalogger_2039 - STM32/Datalogger2039_Display_Test/Core/Src/main.c

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
/* Includes ------------------------------------------------------------------*/
#include "main.h"

/* USER CODE BEGIN Includes */
#include "IWDG_Delay.h"
#include "ILI9341.h"
#include "SCREEN.h"
#include <stdio.h>
#include "logo.h"
#include "DS3231.h"
/* USER CODE END Includes */

IWDG_HandleTypeDef hiwdg;

SPI_HandleTypeDef hspi3;

TIM_HandleTypeDef htim7;
TIM_HandleTypeDef htim8;

/* USER CODE BEGIN PV */
DS3231_Time_t tm1;

extern int lcd_bright_set;
extern int lcd_bright_new;
extern int lcd_bright_old;

extern int lcd_bright_max;
extern int lcd_bright_mid;
extern int lcd_bright_min;
extern int lcd_bright_off;
extern int lcd_bright_for_logo;
/* USER CODE END PV */

void SystemClock_Config(void);
static void MX_GPIO_Init(void);
static void MX_SPI3_Init(void);
static void MX_TIM8_Init(void);
static void MX_TIM7_Init(void);
static void MX_IWDG_Init(void);
/* USER CODE BEGIN PFP */
void print_clock(uint16_t x, uint16_t y, FontDef font, uint16_t color,
		uint16_t bgcolor);

extern void IWDG_delay_ms(uint32_t delay);
extern void IWDG_reset(void);
extern void user_pwm_setvalue(uint16_t value);
extern void draw_logo(const unsigned short *logo);
/* USER CODE END PFP */

/* USER CODE BEGIN 0 */
void print_clock(uint16_t x, uint16_t y, FontDef font, uint16_t color,
		uint16_t bgcolor) {
	char str[80];
	sprintf(str, "%02d:%02d:%02d", tm1.hours, tm1.minutes, tm1.seconds);
	ILI9341_WriteString(x, y, str, font, color, bgcolor);
}
/* USER CODE END 0 */

/**
  * @brief  The application entry point.
  * @retval int
  */
int main(void)
{
  /* MCU Configuration--------------------------------------------------------*/

  /* Reset of all peripherals, Initializes the Flash interface and the Systick. */
  HAL_Init();

  /* Configure the system clock */
  SystemClock_Config();

  /* Initialize all configured peripherals */
  MX_GPIO_Init();
  MX_SPI3_Init();
  MX_TIM8_Init();
  MX_TIM7_Init();
  MX_IWDG_Init();
  /* USER CODE BEGIN 2 */
	HAL_TIM_Base_Start_IT(&htim7);

	HAL_GPIO_WritePin(UC_PWR_GPIO_Port, UC_PWR_Pin, GPIO_PIN_SET); // uC Power On

	HAL_GPIO_WritePin(LCD_PWR_GPIO_Port, LCD_PWR_Pin, GPIO_PIN_SET);
	IWDG_delay_ms(100);

	ILI9341_Unselect();
	IWDG_delay_ms(5);
	ILI9341_Init();

	ILI9341_Unselect();
	IWDG_delay_ms(5);
	ILI9341_Init();

	user_pwm_setvalue(0);

	ILI9341_FillScreen(ILI9341_BLACK);

	draw_logo(STM32F4_logo);

	lcd_bright_set = lcd_bright_for_logo;

	while (lcd_bright_old != lcd_bright_set) {
		IWDG_delay_ms(1);
	}

	lcd_bright_set = lcd_bright_off;

	while (lcd_bright_old != lcd_bright_set) {
		IWDG_delay_ms(1);
	}

	ILI9341_FillScreen(ILI9341_BLACK);

	lcd_bright_set = lcd_bright_max;

	while (lcd_bright_old != lcd_bright_set) {
		IWDG_delay_ms(1);
	}

	tm1.date = 21;
	tm1.day = 1;
	tm1.month = 6;
	tm1.year = 21;
	tm1.hours = 12;
	tm1.minutes = 00;
	tm1.seconds = 00;

	ILI9341_FillScreen(ILI9341_RED);
	IWDG_delay_ms(500);

	ILI9341_FillScreen(ILI9341_GREEN);
	IWDG_delay_ms(500);

	ILI9341_FillScreen(ILI9341_BLUE);
	IWDG_delay_ms(500);

	draw_logo(STM32F4_logo);
  /* USER CODE END 2 */

  /* Infinite loop */
  /* USER CODE BEGIN WHILE */
	while (1) {
    /* USER CODE END WHILE */

    /* USER CODE BEGIN 3 */
		print_clock(220, 5, Font_11x18, ILI9341_BLACK,
		ILI9341_WHITE);
		int seconds_old = tm1.seconds;
		while (seconds_old == tm1.seconds) {
			IWDG_delay_ms(100);
		}

		if (tm1.seconds == 20) {
			lcd_bright_set = lcd_bright_mid;
		} else if (tm1.seconds == 40) {
			lcd_bright_set = lcd_bright_min;
		} else if (tm1.seconds == 0) {
			lcd_bright_set = lcd_bright_max;
		}
	}
  /* USER CODE END 3 */
}

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
