rtek1000/Datalogger_2039/(commit log)

2022-01-08 Software Update
    STM32CubeIDE_1.8.0
2022-01-16 Software Update
    Added Over Current Interrupt for USB Port (and DC-DC monitor)
2022-02-12 Software Update
    LCD Backlight flashing, PWM frequency changed from ~300Hz to ~82kHz
2022-03-08 Update README.md
    Added calibration info
2023-06-27 LCD driver update
    Modify the way to fill the screen
2023-07-09 Update
    Boards for TMP117 support
    [Datalogger2039_TMP117_adapter.kicad_pcb, Datalogger2039_TMP117_adapter.kicad_sch, TMP117_custom_board.csv, TMP117_custom_board.kicad_pcb, TMP117_custom_board.kicad_sch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]
2023-07-24 Update
    Added preliminary option for TMP117 sensor selection
2023-11-01 Update
    Batt volt bug fix/modification
2023-11-12 Update
    IWDG bug fix
    [Datalogger2039_MCU_Pinout.xlsx]
2023-11-13 Update
    Bug fix, incorrect sensor temperature unit (*C/*F)
2025-08-22 Update
    The board was panelized. JLCPCB increased the price of the board without panelization by 9x.
2025-08-22 Update
    Small holes (0.15mm) have been enlarged to (0.25)
